L-terrestris/L-terrestris.github.io/README.md

# L-terrestris.github.io

Project website for Arizona State University EGR 557 FOldable Robotics Class
