L-terrestris/L-terrestris.github.io/index.md

---
title: EGR 557 Team 5
---

# Project Title : How can foldable techniques translate a small number of actuators into unique locomotion?

## Introduction
The team's semester project begun around the general topic of _Navigating Tight Spaces with Foldable Robotics_.\
The team was tasked with researching a more specific question through a semester-long course and following the preliminary research, we settled on modelling a robot with bio-inspiration from the _Lumbricus Terrestris_ commonly known as the _Common Earthworm_.\
However, After half the semester, we had a major project change. We have shifted from tight space navigation to locomotion, and seek to answer the following question:

“How can foldable techniques translate a small number of actuators into unique locomotion?”

Follow [this link](/OldStuff) for details on the previous work conducted on navigating tight spaces. 

## Team Members

| Jacob Sindorf | Javon Grimes | Jonathan Nguyen |Gilgal Ansah |
| <jsindorf@asu.edu> | <jdgrime1@asu.edu> | <jrnguyen@asu.edu> | <gjansah@asu.edu> |

## Assignments

1. [Develop a Research Question](Question/QuestionNew)
2. [Biomechanics Background and Initial Specifications](Biomechanics/BiomechanicsNew)
3. [System Kinematics](Kinematics/KinematicsNew)
4. [System Dynamics](Dynamics/DynamicsNew)
5. [Design Optimization](Optimization/Optimization)
6. [Design and Manufacturing Workflow](Manufacturing/Manufacturing)
7. [Data Collection and Experimental Validation](Validation/Validation)

## Project Presentations
1. [Presentation 1](Presentations/Presentation_1)
2. [Presentation 2](Presentations/Presentation_2)
3. [Presentation 3](Presentations/Presentation_3)

## [Bibliography](/bibliographyNew)
