L-terrestris/L-terrestris.github.io/Presentations/Presentation_3.md

---
title: Presentation 3
---

# Presentation 3

## Description
[Assignment Instructions](https://egr557.github.io/assignments/presentation-III.html)

## Team Response
### Videos
The video shows the final  team presentation.

<iframe width="974" height="548" src="https://www.youtube.com/embed/8ZwU1LzjtIA" title="YouTube video player" frameborder="0" allow="accelerometer; autoplay; clipboard-write; encrypted-media; gyroscope; picture-in-picture" allowfullscreen></iframe>

### [Presentation file](/PDF/Presentation3.pdf)
