L-terrestris/L-terrestris.github.io/Presentations/Presentation_2.md

---
title: Presentation 2
---

# Presentation 2

## Description
[Assignment Instructions](https://egr557.github.io/assignments/presentation-II.html)

## Team Response
### Videos
The video below discusses the team's project shift and covers the new system dynamics, kinematics as well as prototyping material identification.

<iframe width="974" height="548" src="https://www.youtube.com/embed/WqxZr-pha3U" title="YouTube video player" frameborder="0" allow="accelerometer; autoplay; clipboard-write; encrypted-media; gyroscope; picture-in-picture" allowfullscreen></iframe>

### [Presentation file](/PDF/Presentation2.pdf)
