L-terrestris/L-terrestris.github.io/Dynamics/ParameterID.md

---
title: Parameter Identification
---

### [Assignment Instructions](https://egr557.github.io/assignments/dynamics-ii-prep.html)

1. [Kinematics Via Prototyping and CAD](FEA.pdf)
2. [Cantilever Experiment](CantileverBeam)
3. [Prototype - Leg](SarrusLeg)
4. [Prototype - Flexible Spine](Spine)
5. [Motor Analysis](Motor)
