L-terrestris/L-terrestris.github.io/Presentations/Presentation_1.md

---
title: Presentation 1
---

# Presentation 1

## Description
[Assignment Instructions](https://egr557.github.io/assignments/presentation-I.html)

## Team Response
### Videos
The videos show the initial and final takes for the first team presentation.

<iframe width="400" height="315" src="https://www.youtube.com/embed/iwJ6JhAadY0" frameborder="0" allow="accelerometer; autoplay; clipboard-write; encrypted-media; gyroscope; picture-in-picture" allowfullscreen></iframe>

<iframe width="400" height="315" src="https://www.youtube.com/embed/TYOn1yv-m28" frameborder="0" allow="accelerometer; autoplay; clipboard-write; encrypted-media; gyroscope; picture-in-picture" allowfullscreen></iframe>

### [Presentation file](/PDF/Presentation1.pdf)
