L-terrestris/L-terrestris.github.io/PDF/Presentation3.pdf

# Team 5- Final Presentation

### Members:

### Gilgal Ansah Javon Grimes Jonathan Nguyen Jacob Sindorf

### Refined Research Question:

### “How can foldable techniques translate a small number of actuators into unique locomotion?”

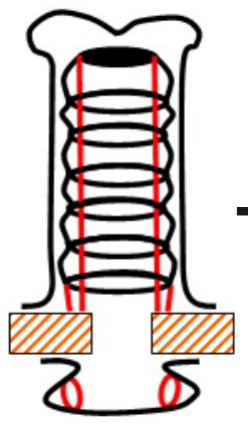
[picture p69: figure]

Figure 1: Tube foot
(podia) bioinspiration [1]

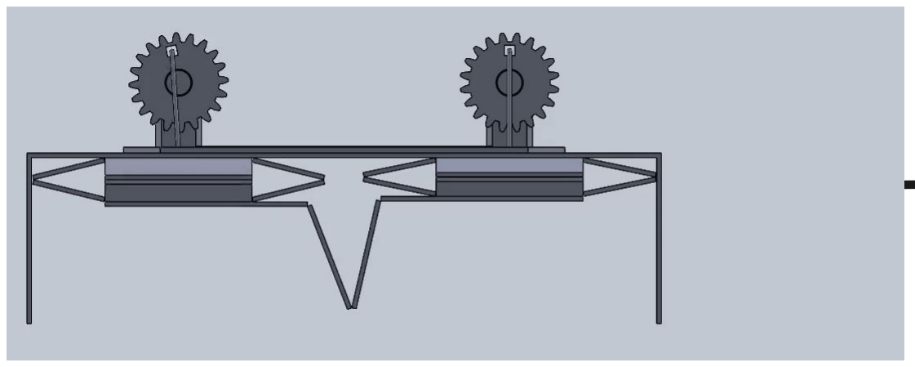
[picture p70: figure]

Figure 2: Conceptual device drawing

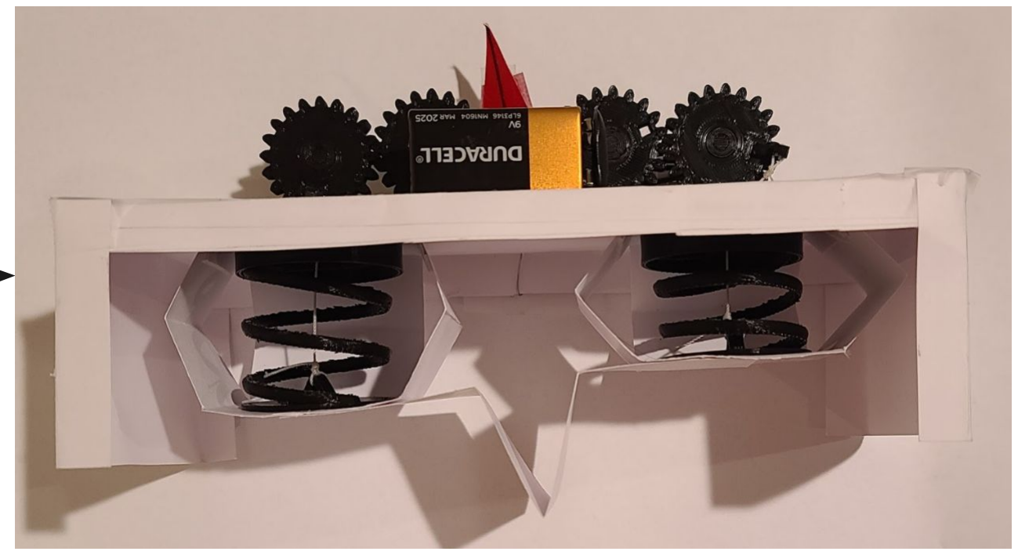
[picture p71: figure]

Figure 3: Final Device Design

# Manufacturing

1 Sheet VS 5 Sheet | Figure 4: 1 Layer Design | Figure 5: 5 Layer Design

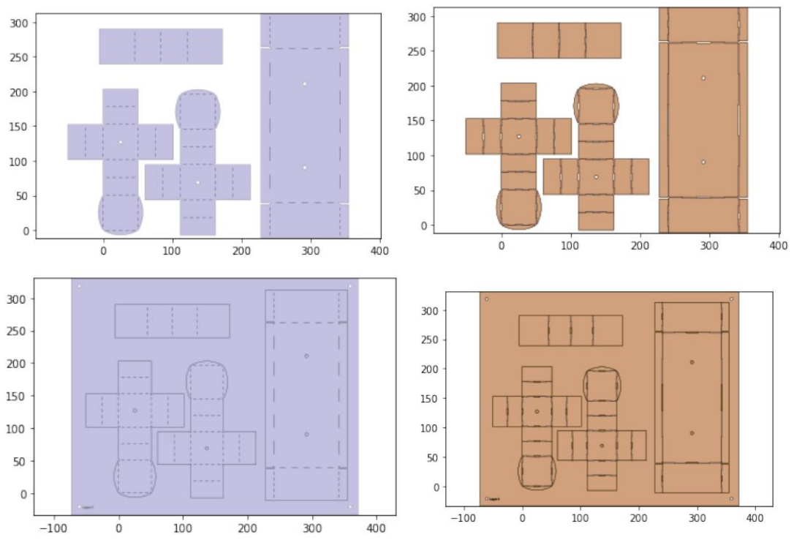
[picture p72: figure]

Pros
- More easily cut out of
single large sheet
- Simpler hinges
- Easier to create digitally

Cons
- Flimsier depending on
materials
- Requires added spring
- Perforated hinges more
subject to degradation
- Less versatility

# Manufacturing- Use in Design

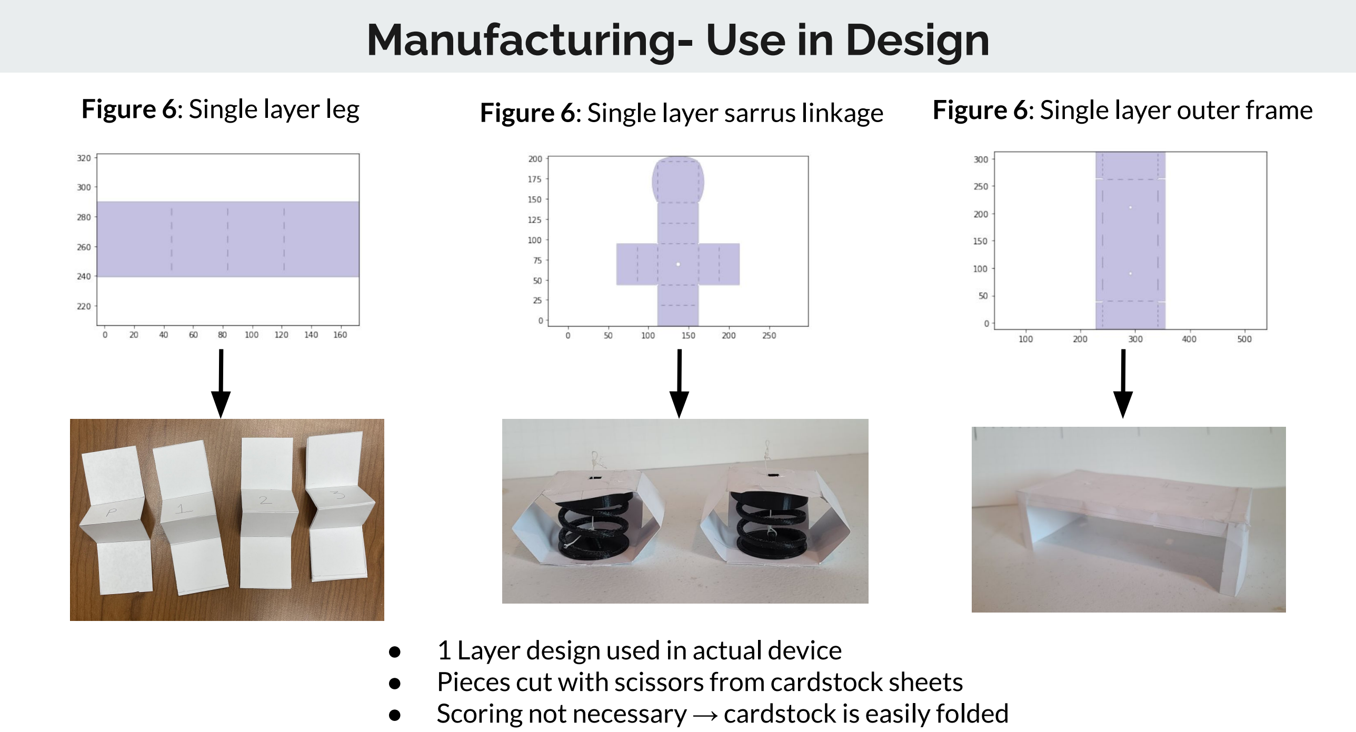
[picture p73: page 3]

- 1 Layer design used in actual device
- Pieces cut with scissors from cardstock sheets
- Scoring not necessary → cardstock is easily folded
Figure 6: Single layer leg | Figure 6: Single layer sarrus linkage | Figure 6: Single layer outer frame

# Optimization

Dynamic model
- Updated with position/time plots
- Measures effectiveness of movement
- Constraints
- Stability of movement
- Amount of movement
- .3 and .6 had best results with .9 dropping in distance
- Test values of .3 to .9 to find optimal value

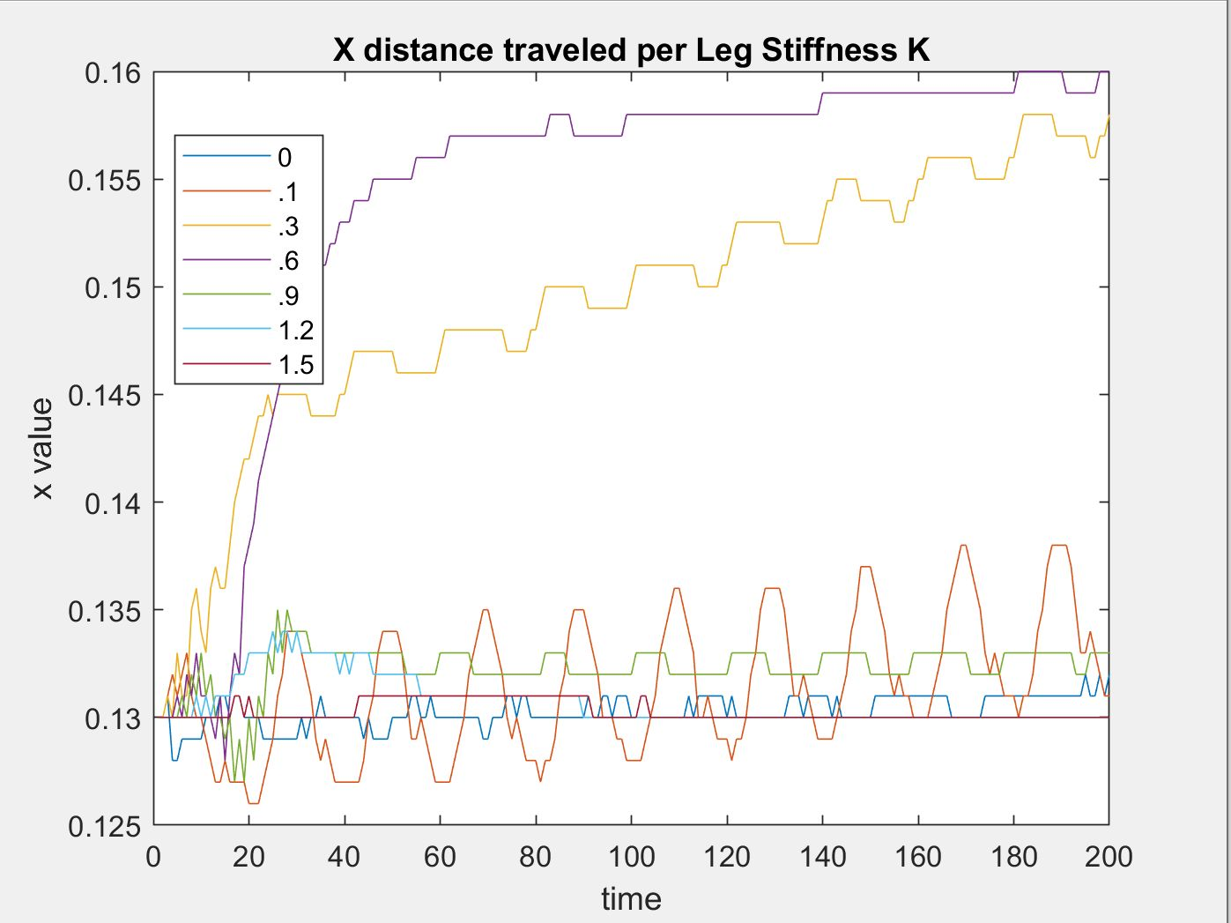
[picture p74: figure]

Figure 9: Varied stiffness values and their overall distance traveled

# Optimization

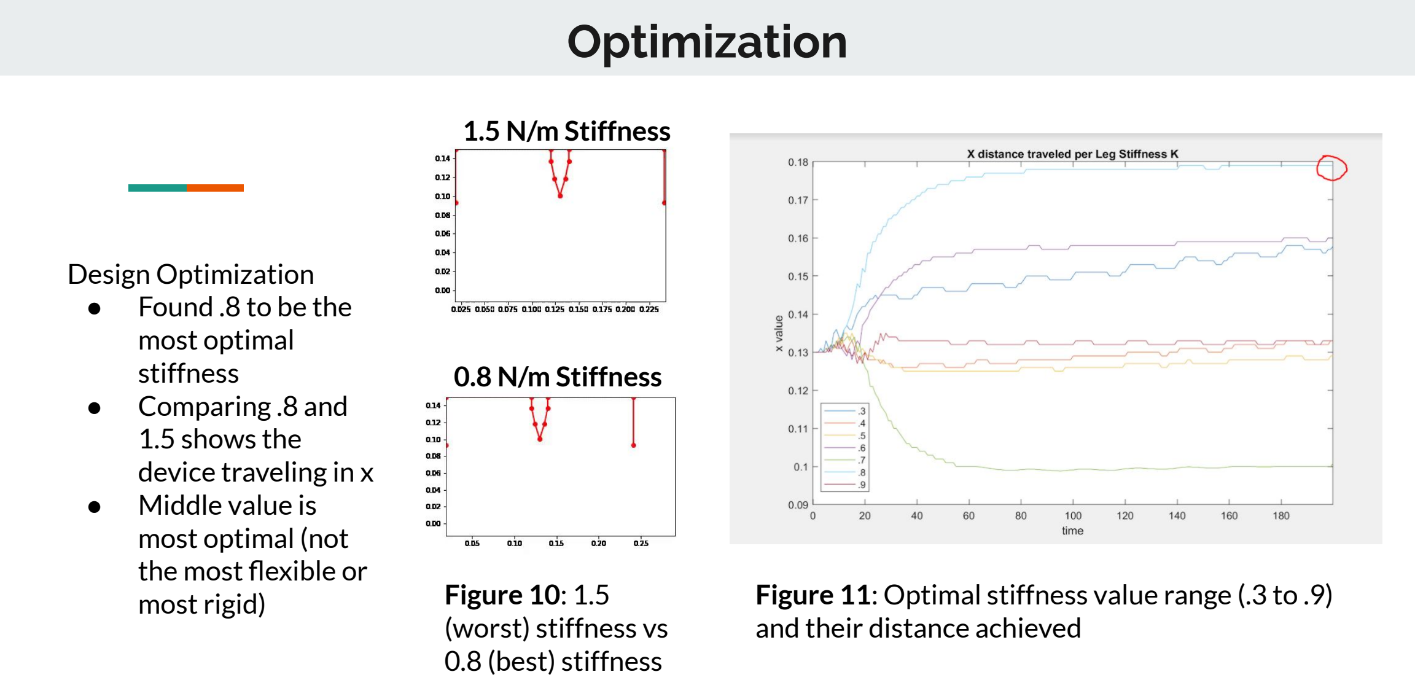
[picture p75: page 5]

Figure 10: 1.5
(worst) stiffness vs
0.8 (best) stiffness

### 1.5 N/m Stiffness

### 0.8 N/m Stiffness

Figure 11: Optimal stiffness value range (.3 to .9) and their distance achieved

Design Optimization
- Found .8 to be the
most optimal
stiffness
- Comparing .8 and
1.5 shows the
device traveling in x
- Middle value is
most optimal (not
the most flexible or
most rigid)

# Experimental Validation - System Assembly

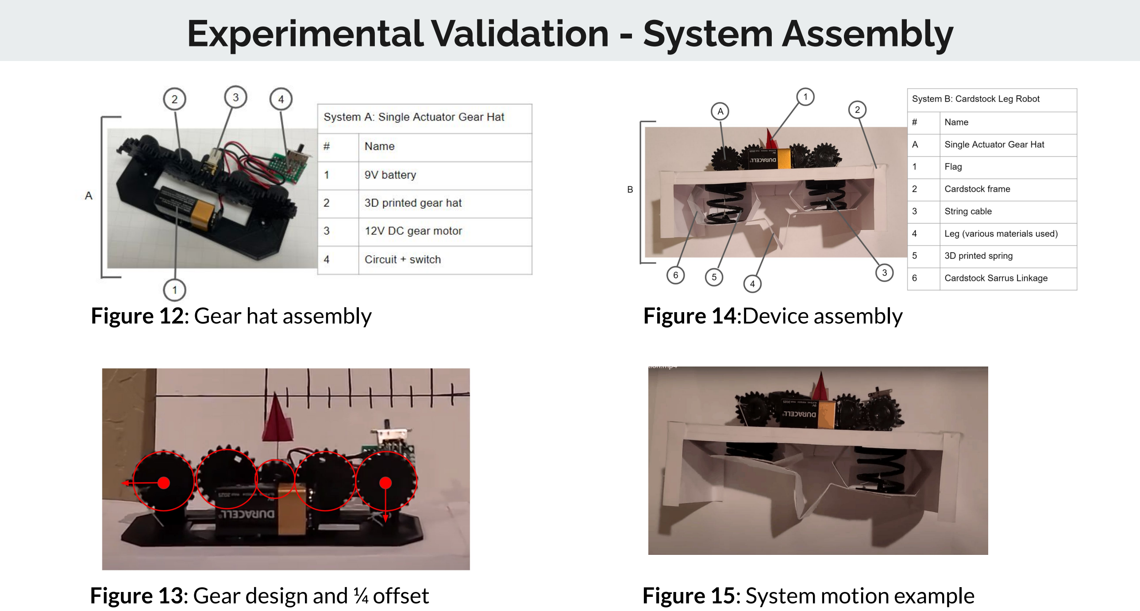
[picture p76: page 6]

Figure 12: Gear hat assembly | Figure 14:Device assembly
Figure 13: Gear design and ¼ offset | Figure 15: System motion example

# Experimental Validation - Experimental Setup

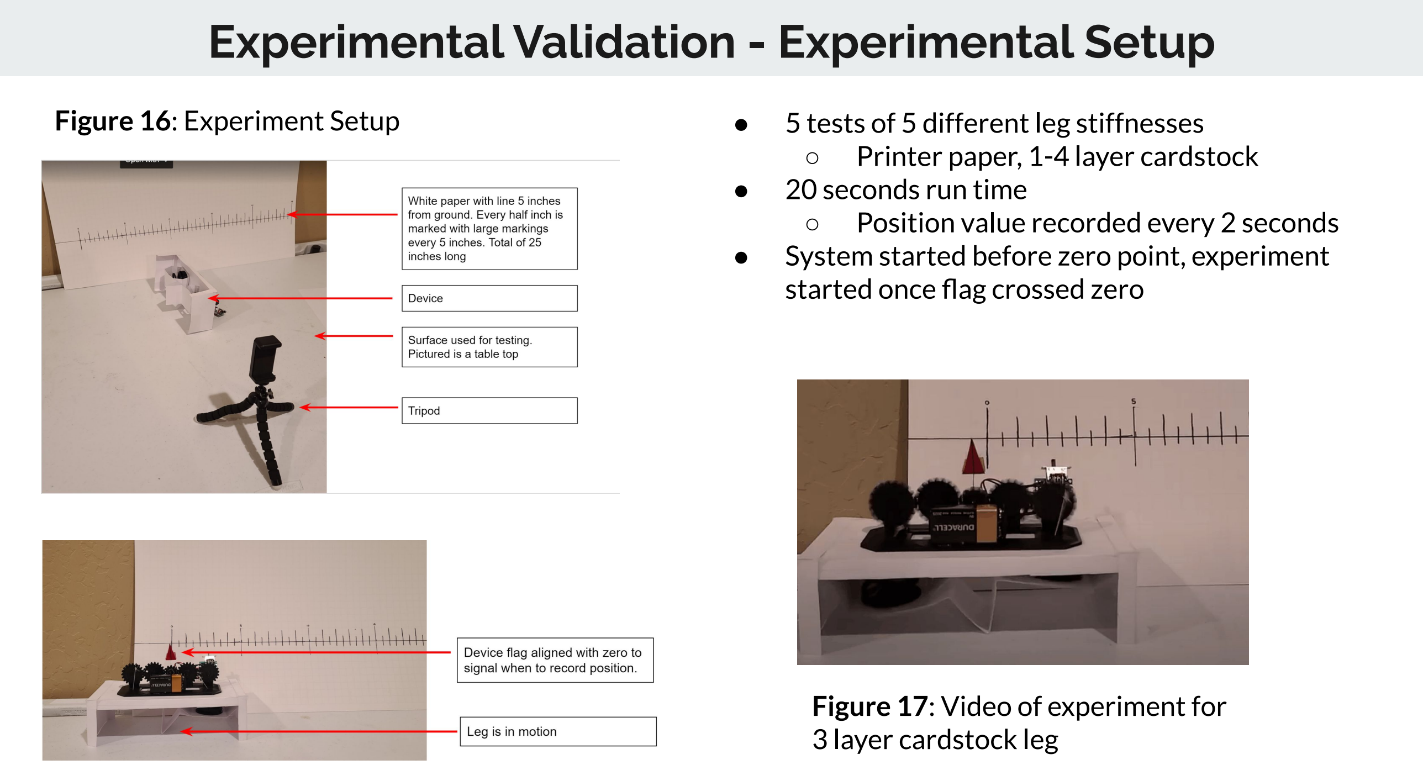
[picture p77: page 7]

Figure 16: Experiment Setup

Figure 17: Video of experiment for 3 layer cardstock leg

- 5 tests of 5 different leg stiffnesses
- Printer paper, 1-4 layer cardstock
- 20 seconds run time
- Position value recorded every 2 seconds
- System started before zero point, experiment started once flag crossed zero

# Experimental Validation - Results

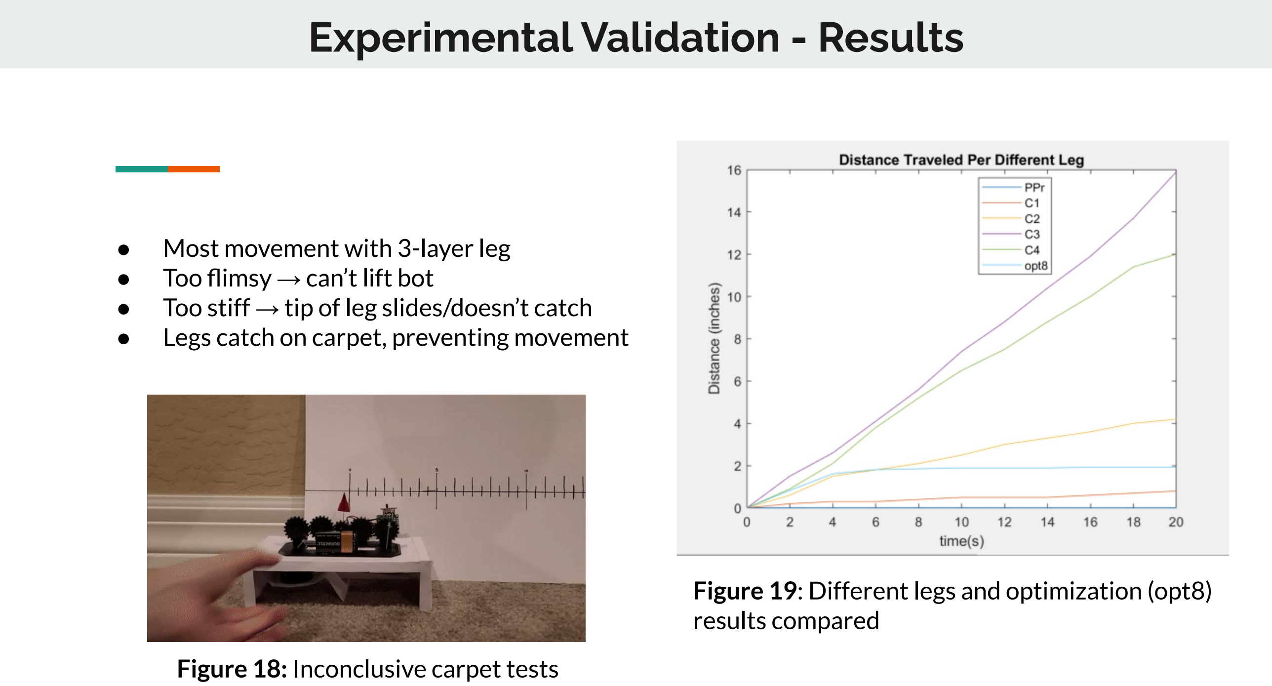
[picture p78: page 8]

- Most movement with 3-layer leg
- Too flimsy → can’t lift bot
- Too stiff → tip of leg slides/doesn’t catch
- Legs catch on carpet, preventing movement

Figure 19: Different legs and optimization (opt8) results compared

Figure 18: Inconclusive carpet tests

# Conclusions

Impact
- Roboticists
- Under-actuated + Low-cost materials + Foldable techniques = Easily manufacturable
- To public
- Foldable techniques provide easily accessible robots and can be used to introduce more people to robotics.
■ Similar to kamigami robots
- To broader research community
- Research of starfish podia is not as prevalent as research of sea urchin podia
- System could be put upside down to move a horizontal plate
■ A more common experiment with podia design

We achieve unique locomotion with a single actuator and a cardstock leg, thus answering our research question. Possible future expansion: multi-layered foldable techniques, alternate methods of under-actuation

# References

[1] Cronodon BioTech, Asteroid mechanics, “Asteroids 2- Hydraulic systems” https://cronodon.com/BioTech/Asteroids_hydraulics.html

# Design Iterations

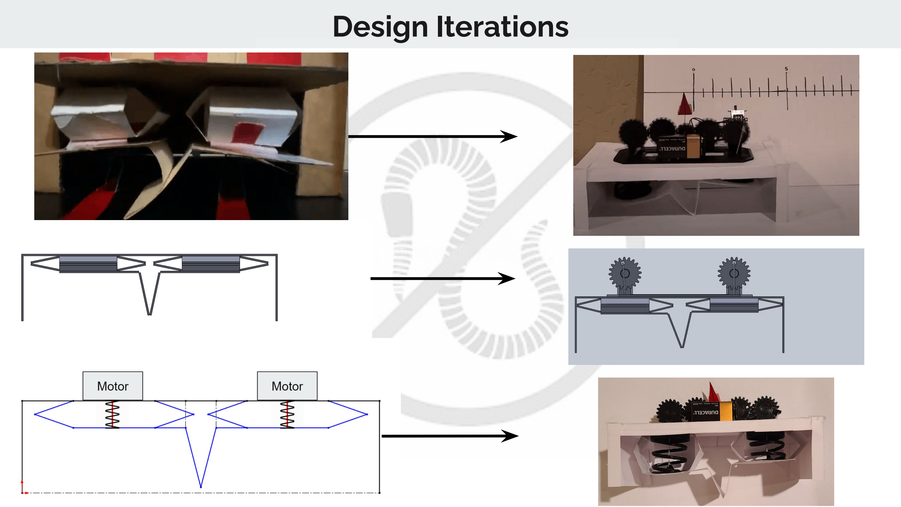
[picture p79: page 11]
