L-terrestris/L-terrestris.github.io/PDF/Presentation2.pdf

# Team 5- Project Update

### Members:

### Gilgal Ansah Javon Grimes Jonathan Nguyen Jacob Sindorf

### Refined Research Question:

### “How can foldable techniques translate a small number of actuators into unique locomotion?”

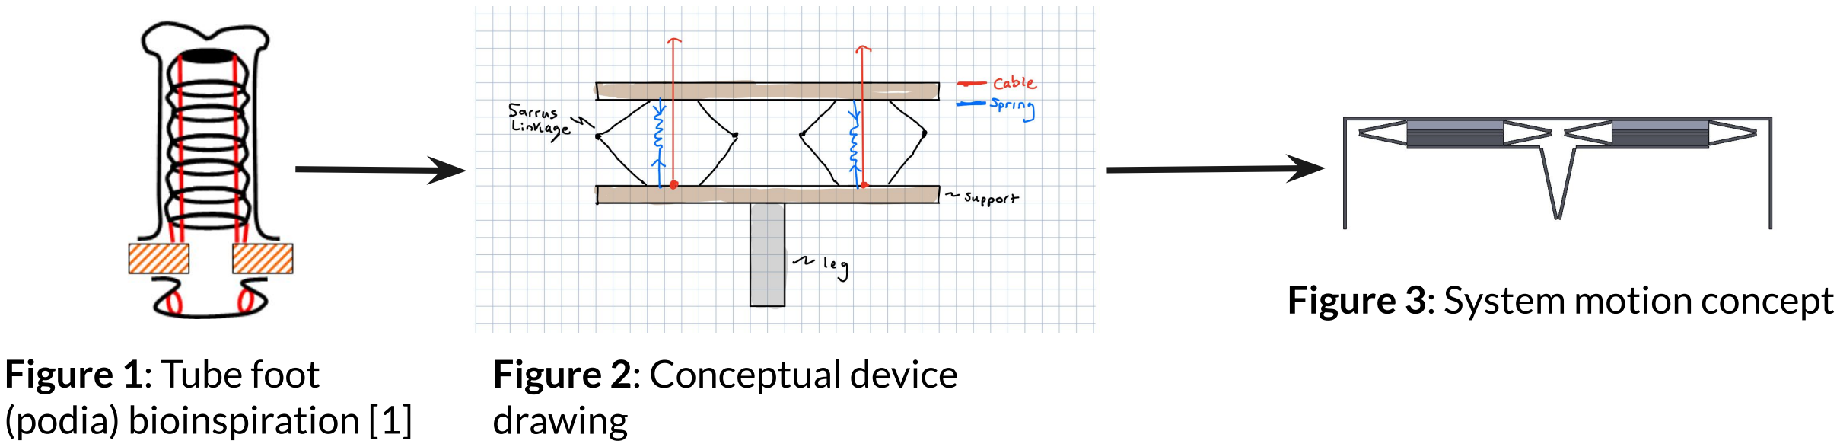
[picture p80: figure]
Figure 1: Tube foot (podia) bioinspiration [1]; Figure 2: Conceptual device drawing; Figure 3: System motion concept

- Bio-Inspiration change

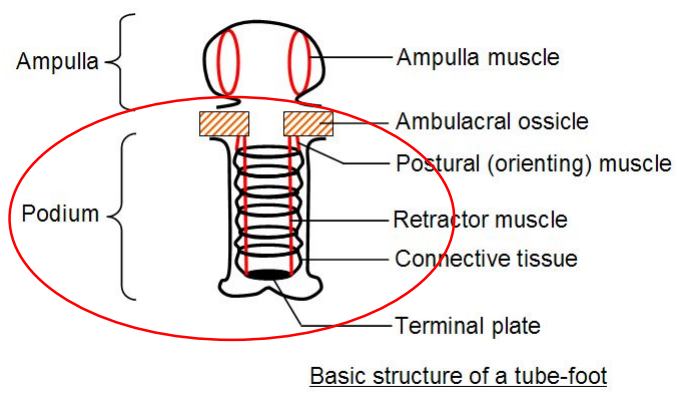
[picture p81: figure]

- Lumbricus Terrestris peristalsis → starfish tube foot (podia)
- More interesting motion through foldable techniques.
- Spec Changes?
- Cardstock still viable; can be layered for strength/stiffness.
- Only need to support weight of actuator/power source/controller → Number of actuators remains the same.
■ More actuators → more complex motion achievable
- Sarrus linkage properties able to be reused.

# Current Specifications

Figure 4: Basic structure
of a tube foot [1]

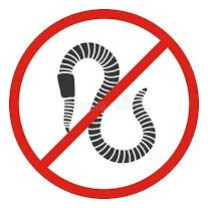
[picture p82: figure]

# Dynamics

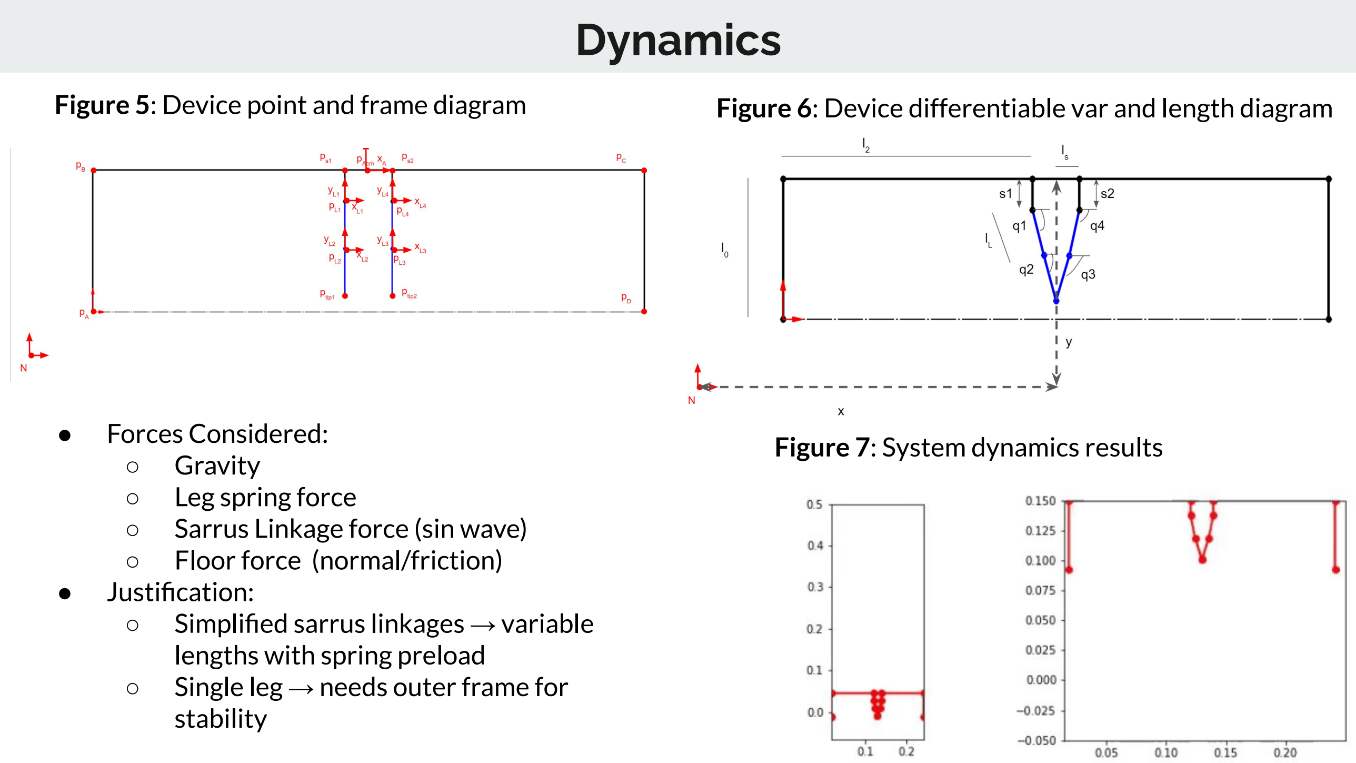
[picture p83: page 3]

Figure 5: Device point and frame diagram | Figure 6: Device differentiable var and length diagram
Figure 7: System dynamics results ● | Forces Considered:
- Gravity
- Leg spring force
- Sarrus Linkage force (sin wave)
- Floor force (normal/friction)
- Justification:
- Simplified sarrus linkages → variable lengths with spring preload
- Single leg → needs outer frame for stability

# Data Collection, Parameter Id, and Model Fitting

# Prototype and Motion

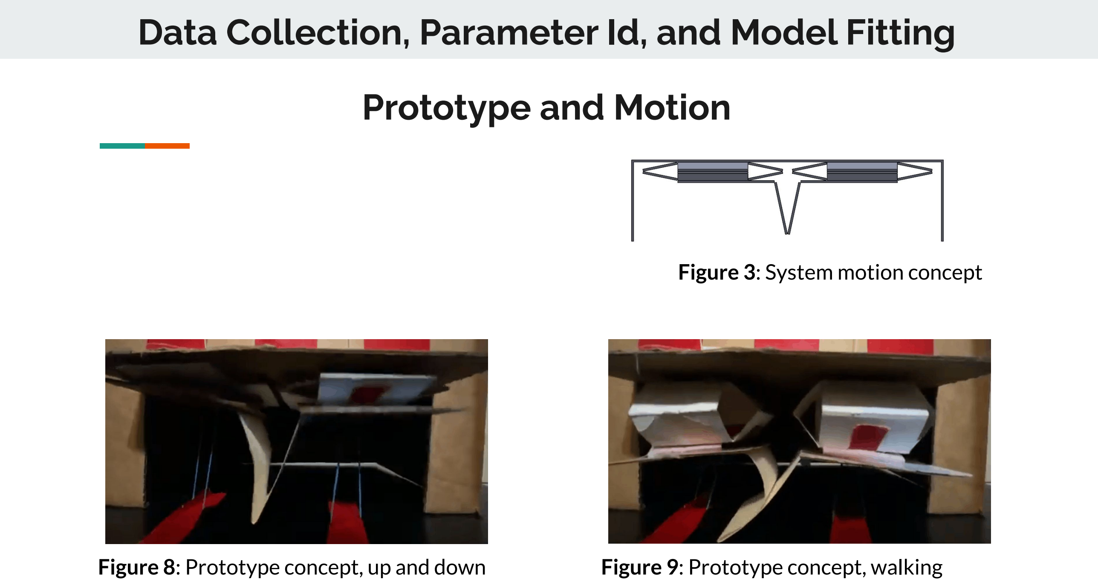
[picture p84: page 4]

Figure 3: System motion concept

Figure 8: Prototype concept, up and down | Figure 9: Prototype concept, walking

# Data Collection, Parameter Id, and Model Fitting

# Cantilever Beam and Stiffness

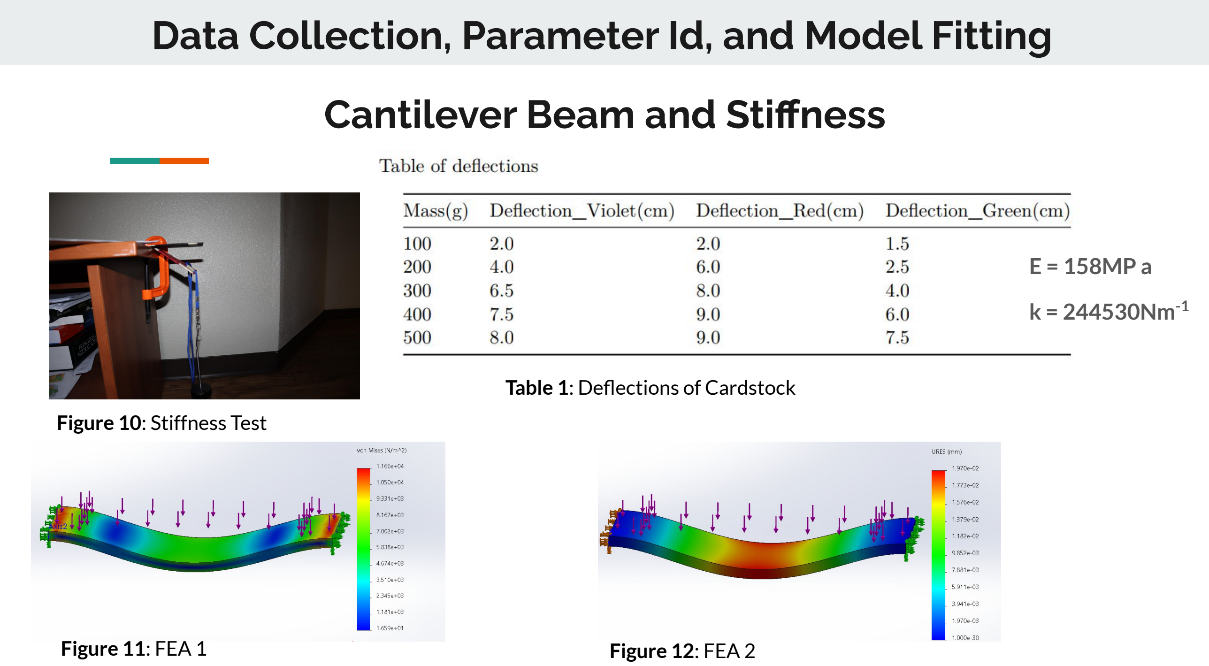
[picture p85: page 5]

E = 158MP a

k = 244530Nm⁻¹

Figure 10: Stiffness Test

Figure 11: FEA 1 | Figure 12: FEA 2

Table 1: Deflections of Cardstock

# Motor Analysis and System Weight

Metric | Value
Voltage Range (VDC) | 3-12
Max Current (A) | 0.17
Max Torque (N-m) | 0.002481
Pulley Radius (cm) | 2.54
Force(mN) | 97.68
Motor Weight (g) | 50
System Weight (g) | 57

# Data Collection, Parameter Id, and Model Fitting

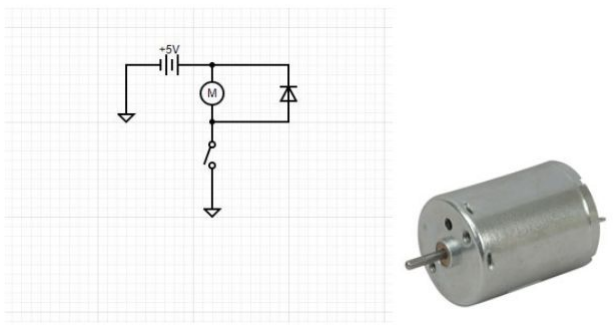
[picture p86: figure]

Figure 13: Motor circuit diagram and DC
Table 2 | motor : Motor Specifications

# Future Plans

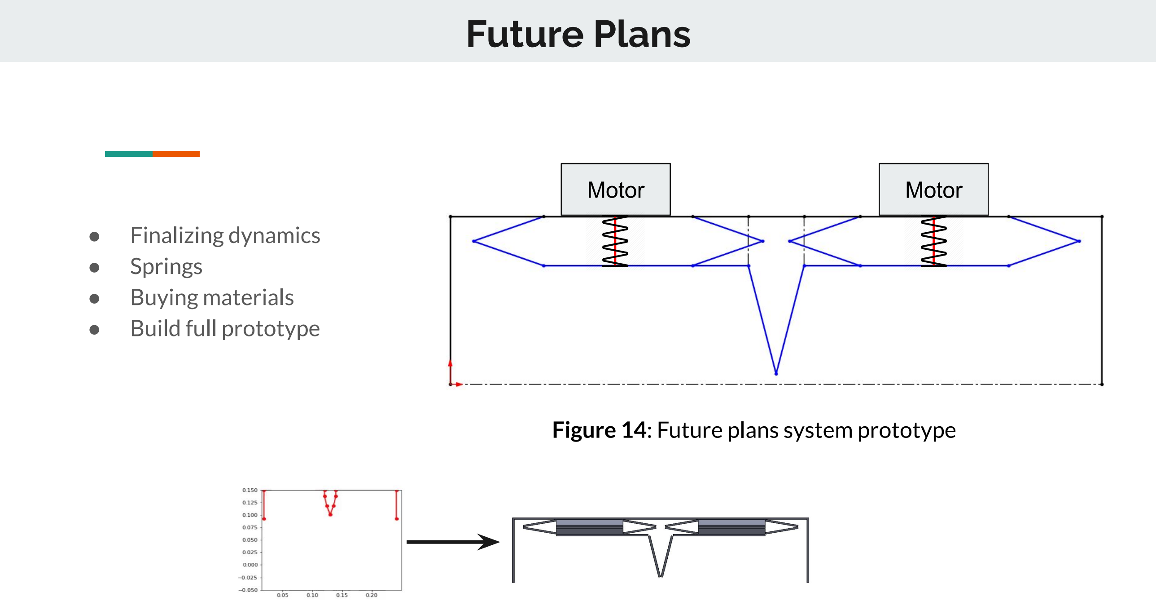
[picture p87: page 7]

| Motor | Motor
- Finalizing dynamics ● Springs ● Buying materials ● Build full prototype

Figure 14: Future plans system prototype

# References

[1] Cronodon BioTech, Asteroid mechanics, “Asteroids 2- Hydraulic systems” https://cronodon.com/BioTech/Asteroids_hydraulics.html
