L-terrestris/L-terrestris.github.io/Dynamics/V2Team5_SystemDynamics.md

```python
%matplotlib inline
```

```python
global_q = False
use_constraints = True
```

```python
!pip install pypoly2tri idealab_tools foldable_robotics pynamics
```

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

```python
# -*- coding: utf-8 -*-
"""
Written by Daniel M. Aukes
Email: danaukes<at>gmail.com
Please see LICENSE for full license.
"""

import pynamics
from pynamics.frame import Frame
from pynamics.variable_types import Differentiable,Constant
from pynamics.system import System
from pynamics.body import Body
from pynamics.dyadic import Dyadic
from pynamics.output import Output,PointsOutput
from pynamics.particle import Particle
import pynamics.integration
import sympy
import numpy
import scipy.optimize
import matplotlib.pyplot as plt
plt.ion()
from math import pi
```

```python
system = System()
pynamics.set_system(__name__,system)
```

```python

```

# Proposed System Kinematics v2



## Parameterization

### Constants

```python
h = Constant(0.0381, 'h',system) #height off the ground due to the front plate (can be set to 0 in the future)
l0 = Constant(0.0508,'l0',system)
la = Constant(0.0254,'la',system)
lb = Constant(0.0254,'lb',system)
lc = Constant(0.0254,'lc',system)
ld = Constant(0.0254,'ld',system)

#Changed to smaller weight to be more reasonable with the system
mA = Constant(.01,'mA',system)
mB = Constant(.01,'mB',system)
mC = Constant(.01,'mC',system)
mD = Constant(.01,'mC',system)

g = Constant(9.81,'g',system)
b = Constant(1e1,'b',system) #damping
k = Constant(1e1,'k',system) #spring force

#spring preloads to system
preload1 = Constant(20*pi/180,'preload1',system) # At-rest angle of NA (A w.r.t. N)
preload2 = Constant(-40*pi/180,'preload2',system) # At-rest angle of AB (B w.r.t. A)
preload3 = Constant(-40*pi/180,'preload3',system) # At-rest angle of DC (C w.r.t. D)
preload4 = Constant(20*pi/180,'preload4',system) # At-rest angle of ND (D w.r.t. N)

Ixx_A = Constant(1,'Ixx_A',system)
Iyy_A = Constant(1,'Iyy_A',system)
Izz_A = Constant(1,'Izz_A',system)
Ixx_B = Constant(1,'Ixx_B',system)
Iyy_B = Constant(1,'Iyy_B',system)
Izz_B = Constant(1,'Izz_B',system)
Ixx_C = Constant(1,'Ixx_C',system)
Iyy_C = Constant(1,'Iyy_C',system)
Izz_C = Constant(1,'Izz_C',system)
Ixx_D = Constant(1,'Ixx_D',system)
Iyy_D = Constant(1,'Iyy_D',system)
Izz_D = Constant(1,'Izz_D',system)

```

```python
tol = 1e-12
```

```python
#Animation stuff
tinitial = 0
tfinal = 10
fps = 30
tstep = 1/fps
t = numpy.r_[tinitial:tfinal:tstep]
```

```python
# Creating dynamic state variables. system argument denotes them as state variables for pynamics system from above
qA,qA_d,qA_dd = Differentiable('qA',system) #Angle between N and A
qB,qB_d,qB_dd = Differentiable('qB',system) #from AB
qC,qC_d,qC_dd = Differentiable('qC',system)
qD,qD_d,qD_dd = Differentiable('qD',system) #from DE

```

```python
#Initial condition based geometrically off of a solidworks model
#given 85 and 170 puts it into the 'compressed' state
#2bar
initialvalues = {}
# Setting initial angle values. See above for angle positions
#Listed are important angle configurations
#Smallest(Compressed) 85,170
#Middle ~45,90
#Largest(Extended) 0,0
initialvalues[qA]=85*pi/180  #45
initialvalues[qA_d]=0*pi/180 
initialvalues[qB]=-170*pi/180   #-90
initialvalues[qB_d]=0*pi/180

initialvalues[qC]=170*pi/180 #90
initialvalues[qC_d]=0*pi/180
initialvalues[qD]=-85*pi/180   #-45
initialvalues[qD_d]=0*pi/180
```

```python
statevariables = system.get_state_variables() # tried running this after vector calculation like i kinematics, but no apparent change...
ini0 = [initialvalues[item] for item in statevariables]
```

```python
N = Frame('N') # Initializing frames
A = Frame('A')
B = Frame('B')
C = Frame('C')
D = Frame('D')
```

```python
system.set_newtonian(N)
```

```python
#if not global_q:
#set rotation logic of frames. Kept all z at one and left the negative value in the initial condition calculation
#changing this caused errors in the system
A.rotate_fixed_axis_directed(N,[0,0,1],qA,system) # A reference frame rotates about N's ref frame in Z direction by qA amount
B.rotate_fixed_axis_directed(A,[0,0,1],qB,system)
C.rotate_fixed_axis_directed(D,[0,0,1],qC,system)
D.rotate_fixed_axis_directed(N,[0,0,1],qD,system)

#rotate each about the global reference frame. Add if else later to see which method is simpler
#else:
#  A.rotate_fixed_axis_directed(N,[0,0,1],qA,system) # A reference frame rotates about N's ref frame in Z direction by qA amount
#  B.rotate_fixed_axis_directed(N,[0,0,1],qB,system)
#  C.rotate_fixed_axis_directed(N,[0,0,1],qC,system)
#  D.rotate_fixed_axis_directed(N,[0,0,1],qD,system)
```

Vectors

claculated by using solving the two 2bar problem. Each vector containts the length constant and the previous point given the local reference frame. 

```python

pA = 0*N.x + (l0 + h)*N.y + 0*N.z

pB = pA + la*A.x
pBtip = pB + lb*B.x

pD = 0*N.x + h*N.y + 0*N.z
pC = pD + ld*D.x
pCtip = pC + lc*C.x

```

Center of mass

Considered the midpoint of each link as they will be uniform in size and material

```python
pAcm=pA+(la/2)*A.x
pBcm=pB+(lb/2)*B.x
pCcm=pC+(lc/2)*C.x
pDcm = pD + (ld/2)*D.x
pBCcm = pCtip + (l0/2)*N.y #get end effector 
```

Angular Velocity

```python
wNA = N.getw_(A) #Angular velocity of vector A w.r.t. N
wAB = A.getw_(B) #Angular velocity of vector B w.r.t. A
wDC = D.getw_(C) #Angular velocity of vector C w.r.t. D
wND = N.getw_(D) #Angular velocity of vector D w.r.t. N
```

```python
#vCtip = pCtip.time_derivative(N,system)
```

Define Inertias & Bodies

```python
IA = Dyadic.build(A,Ixx_A,Iyy_A,Izz_A)
IB = Dyadic.build(B,Ixx_B,Iyy_B,Izz_B)
IC = Dyadic.build(C,Ixx_C,Iyy_C,Izz_C)
ID = Dyadic.build(D,Ixx_D,Iyy_D,Izz_D)

BodyA = Body('BodyA',A,pAcm,mA,IA,system)
BodyB = Body('BodyB',B,pBcm,mB,IB,system)
BodyC = Body('BodyC',C,pCcm,mC,IC,system)
BodyD = Body('BodyD',D,pDcm,mD,ID,system)
BodyBCp = Particle(pBCcm,mB,'ParticleBC',system) #would we also need bodyE 
```

Forces & Torques

Defines the system forces, mainly relying on the spring force

```python
system.addforce(-b*wNA,wNA)
system.addforce(-b*wAB,wAB)
system.addforce(-b*wDC,wDC)
system.addforce(-b*wND,wND)

```

    <pynamics.force.Force at 0x7efdccdb2210>

```python
##########################################
#Shouldn't we only consider spring force on one point ? 
#########################################
#if not global_q:
system.add_spring_force1(k,(qA-preload1)*N.z,wNA)
system.add_spring_force1(k,(qB-preload2)*A.z,wAB)
system.add_spring_force1(k,(qC-preload3)*D.z,wDC)
system.add_spring_force1(k,(qD-preload4)*N.z,wND)
  
#else:
#    system.add_spring_force1(k,(qA-preload1)*N.z,wNA) 
#    system.add_spring_force1(k,(qB-qA-preload2)*N.z,wAB)
#    system.add_spring_force1(k,(qC-qD-preload3)*N.z,wDC)
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
