L-terrestris/L-terrestris.github.io/OldStuff.md

---
title: Navigating Tight Spaces
---

## Navigating Tight Spaces

The following describe the work done by our team in the space of designing a robot to navigate tight spaces using a small number of actuators. 

1. [Develop a Research Question](Question/Question)
2. [Biomechanics Background and Initial Specifications](Biomechanics/Biomechanics)
3. [System Kinematics](Kinematics/Kinematics)
4. [System Dynamics](Dynamics/Dynamics)

## [Bibliography](/bibliography)
