L-terrestris/L-terrestris.github.io/Manufacturing/Single_Layer_Cut.dxf

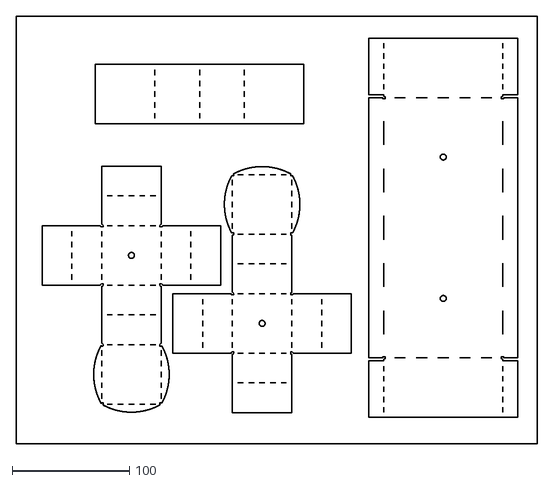
[picture p100: CAD file, 2021-04-16]
Manufacturing/Single_Layer_Cut.dxf
444.6 x 364.6
