L-terrestris/L-terrestris.github.io/Manufacturing/final_cut.dxf

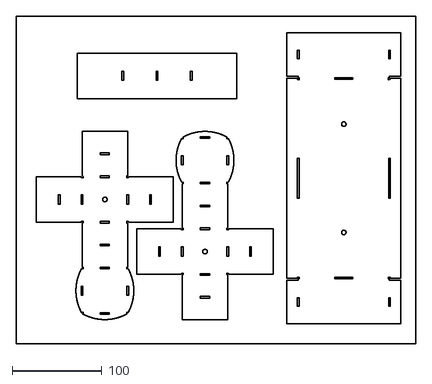
[picture p101: CAD file, 2021-04-16]
Manufacturing/final_cut.dxf
444.6 x 364.6
