L-terrestris/L-terrestris.github.io/Manufacturing/designJoints.dxf

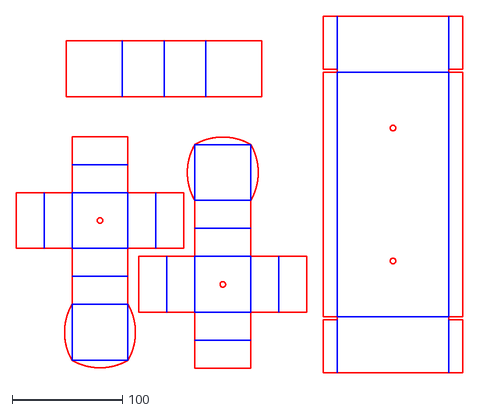
[picture p102: CAD file, 2021-04-16]
Manufacturing/designJoints.dxf
405.8 x 323.9
