L-terrestris/L-terrestris.github.io/Manufacturing/design.dxf

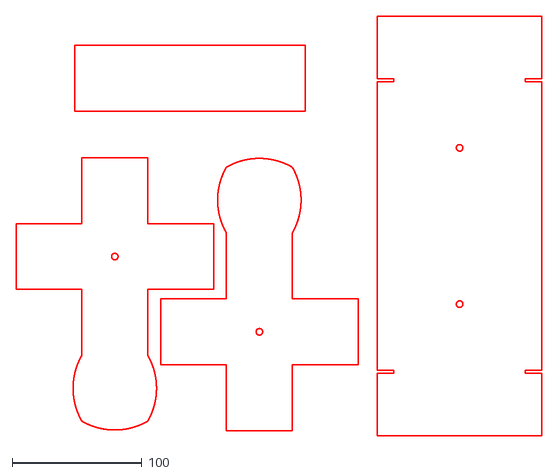
[picture p103: CAD file, 2021-04-16]
Manufacturing/design.dxf
405.8 x 323.9
