L-terrestris/L-terrestris.github.io/Manufacturing/rigid_layer.dxf

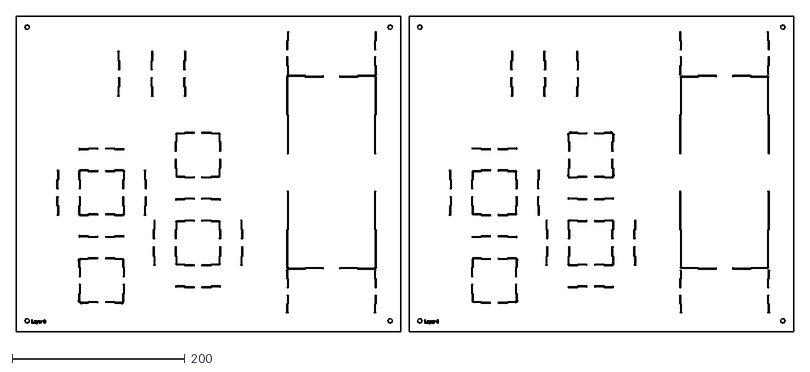
[picture p104: CAD file, 2021-04-16]
Manufacturing/rigid_layer.dxf
899.2 x 364.6
