L-terrestris/L-terrestris.github.io/Manufacturing/adhesive_layer.dxf

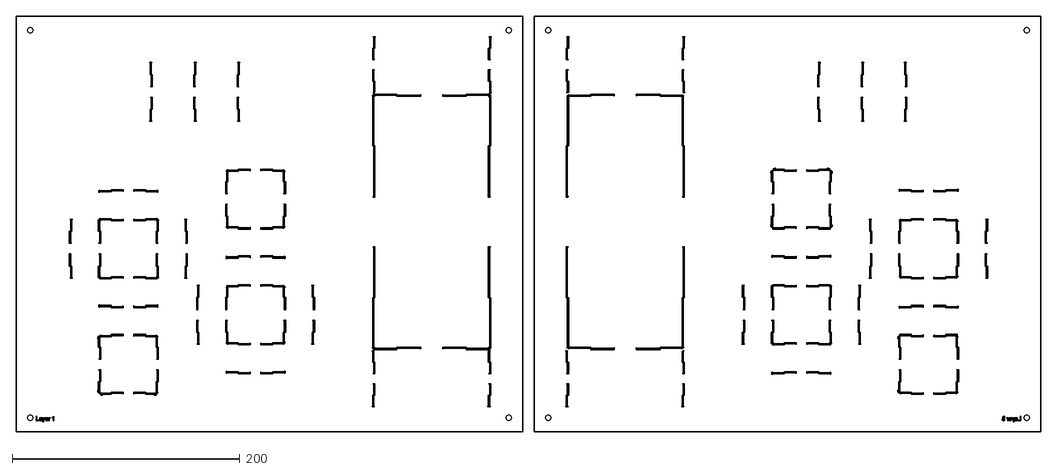
[picture p105: CAD file, 2021-04-16]
Manufacturing/adhesive_layer.dxf
899.2 x 364.6
