L-terrestris/L-terrestris.github.io/(list of files, cad)

Other CAD files:
Manufacturing/designJoints.dwg
