L-terrestris/L-terrestris.github.io/Manufacturing/Manufacturing.md

---
title: Design and Manufacturing Workflow
---

# 1 Paper Mockup

The paper mock up is identical to the solidworks design seen after. It uses the same measurements as the dynamics II assignments, and is made of cardboard (frame) and cardstock (leg and links). To hold everything together, tape can be used, but the final device would use glue as it would provide a cleaner connection. 

Folded:\
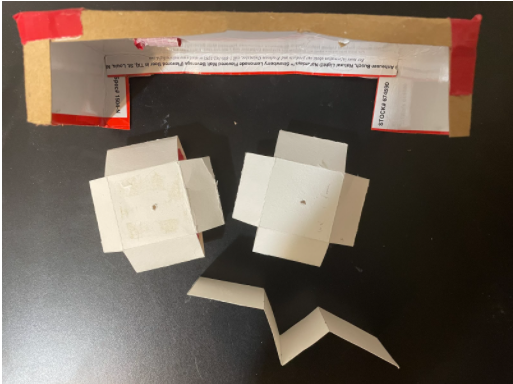
[picture p106: Manufacturing/PaperModelApart.PNG]

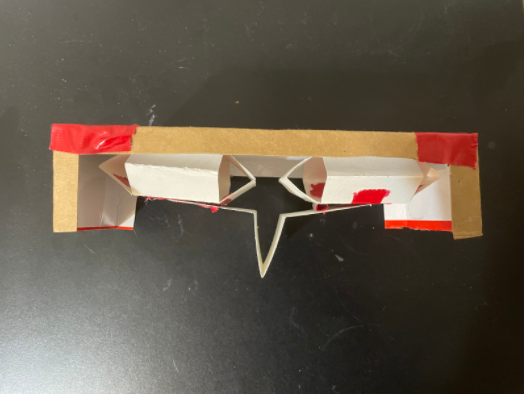
[picture p107: Manufacturing/PaperModelAssembled.PNG]


Flattened:\
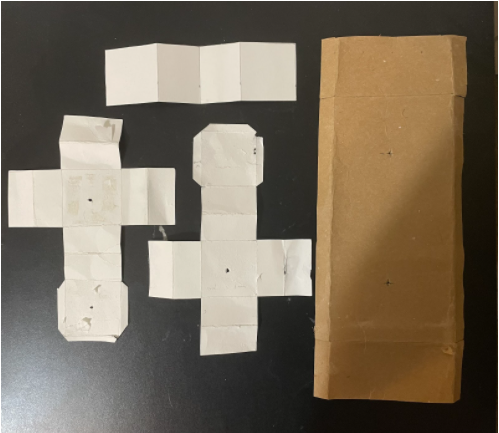
[picture p108: Manufacturing/PaperModelFlat.PNG]


# 2 Solidworks Model

The solidworks model seen here is a 3D version of our design. The folded states depicts both the assembled and exploded view for clarity. The flattened state represents the unfolded assembly in a way that can be used for manufacturing later. The system itself consists of 3 main parts, the sarrus linkages (x2), the frame, and the leg. Holes in the device are for the motor cable to move through, and flaps are used to adhere joints to one another. 

Folded:
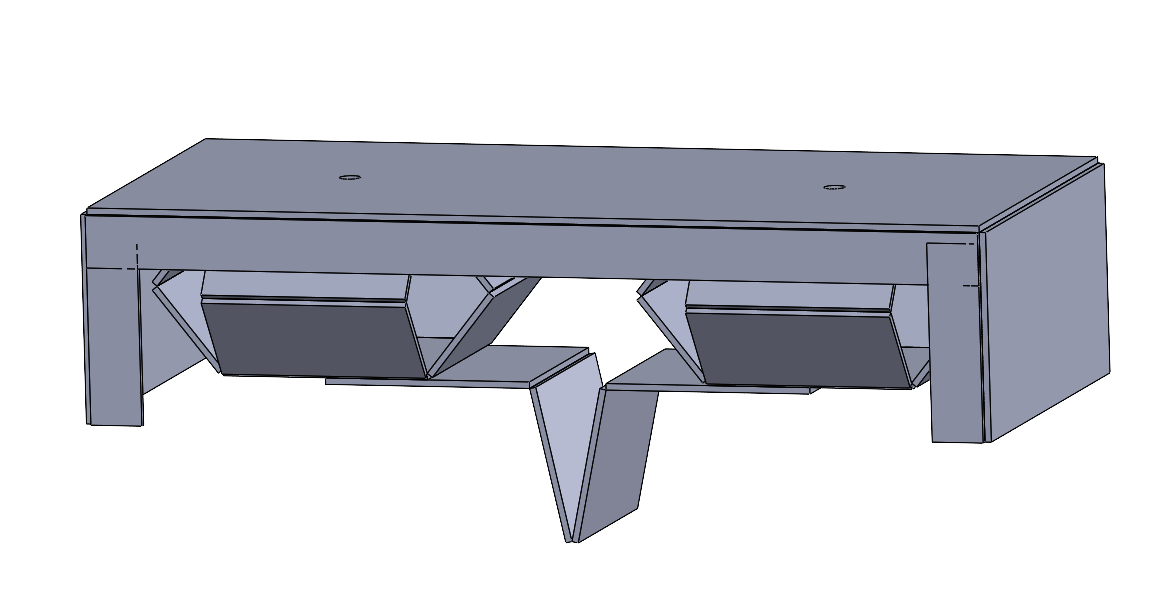
[picture p109: Manufacturing/SystemFolded.PNG]

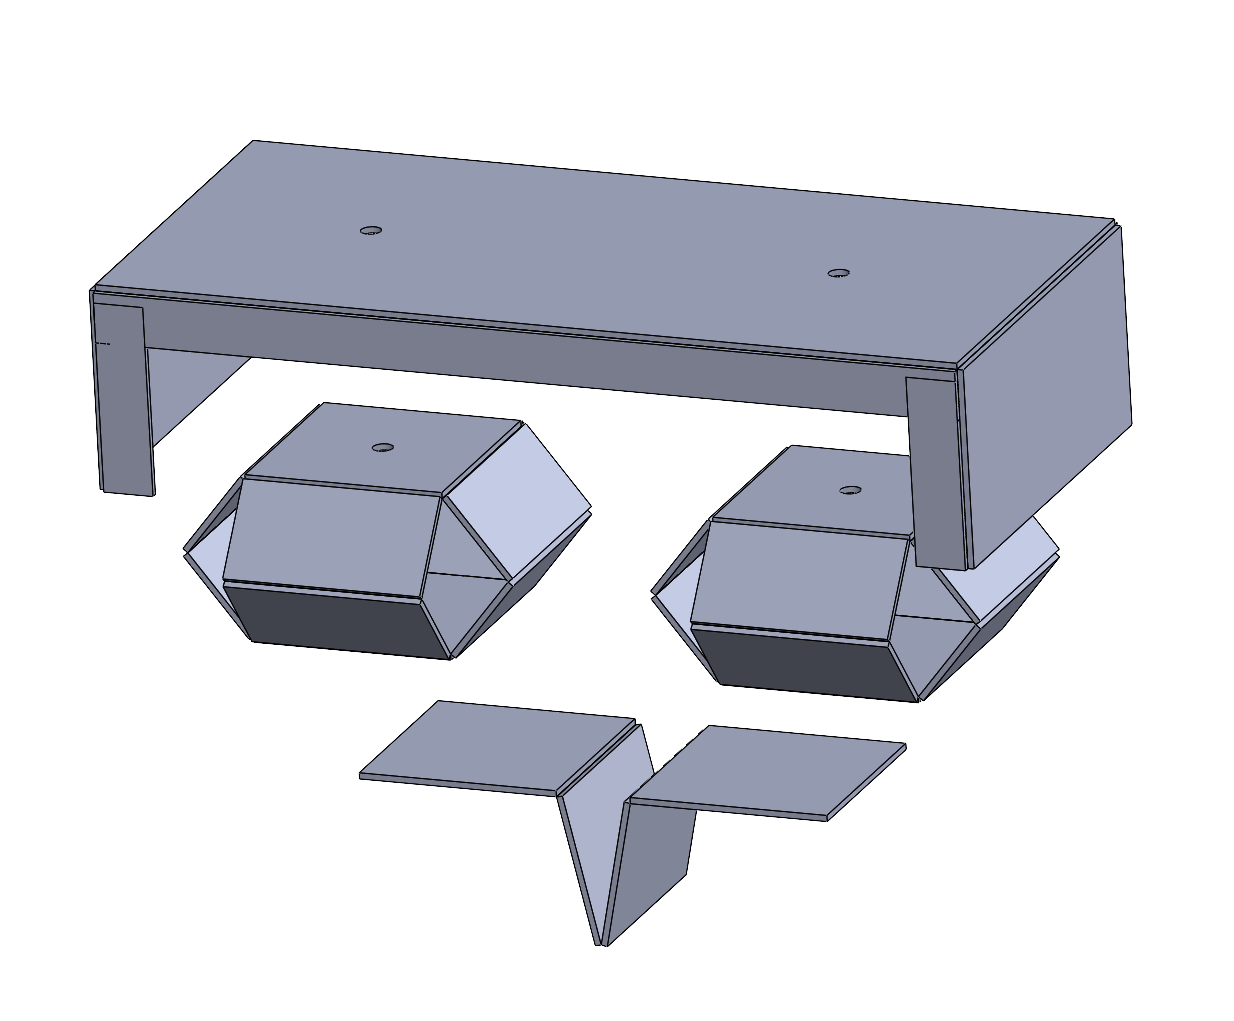
[picture p110: Manufacturing/SystemFoldedEXPL.PNG]


Flattened:
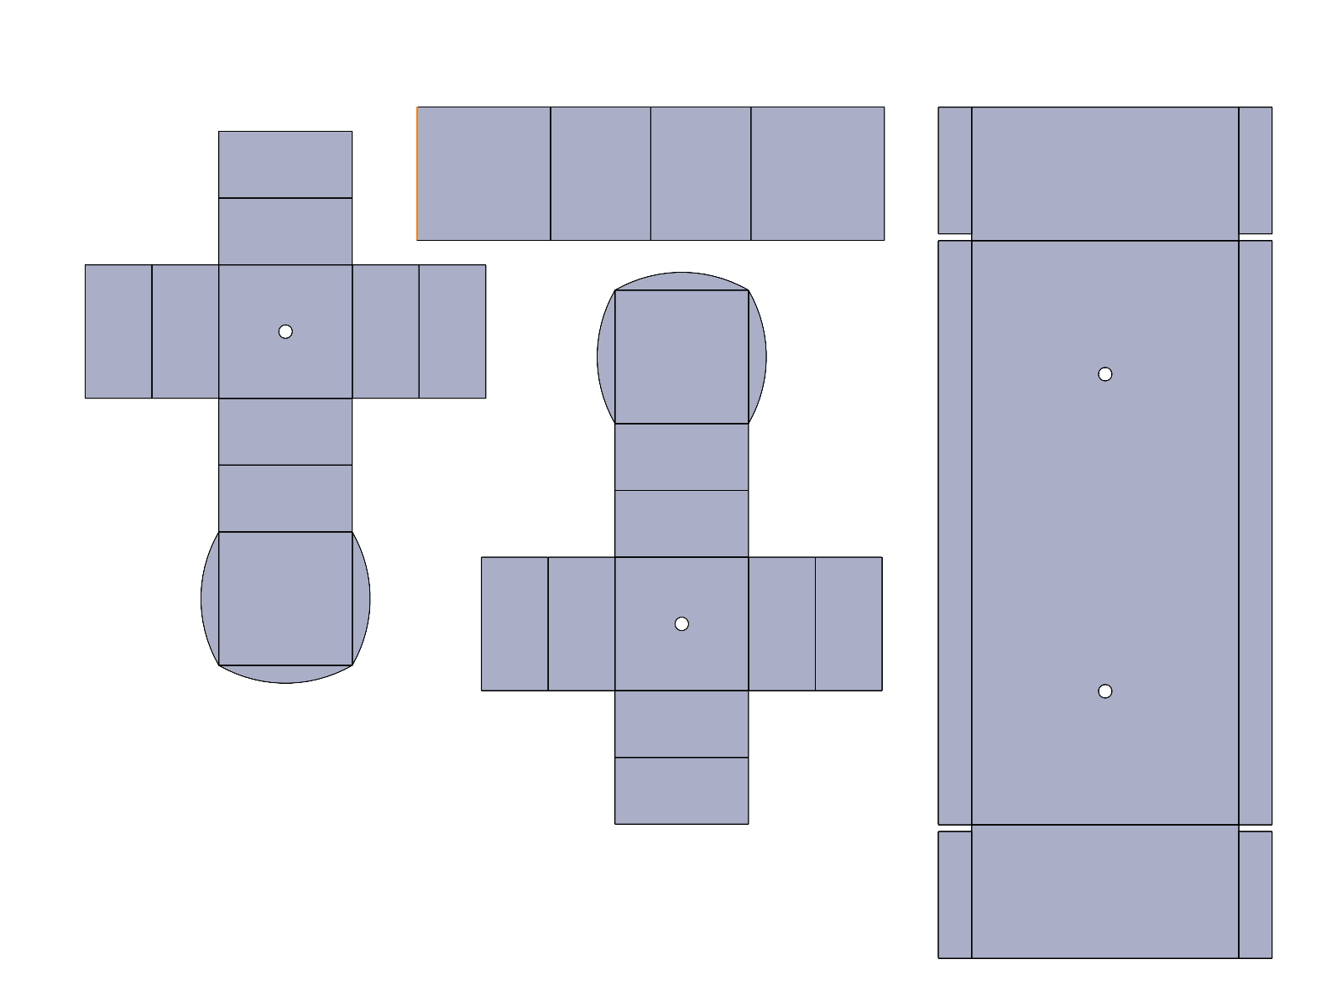
[picture p111: Manufacturing/SystemFlattened.PNG]


# 3 DXF file 

The dxf file directly from solidworks (the method of retrieving the yaml file, then getting the dxf) had issues that left every joint. To troubleshoot, we attempted to add more verticies, and even manually adding them in the program draft sight, both to no avail. Eventually, we found a different program called libreCAD that functions similarly to draft sight. This allowed us to finally obtain the proper dxf file needed, with both body (red) and joint (blue) layers. 

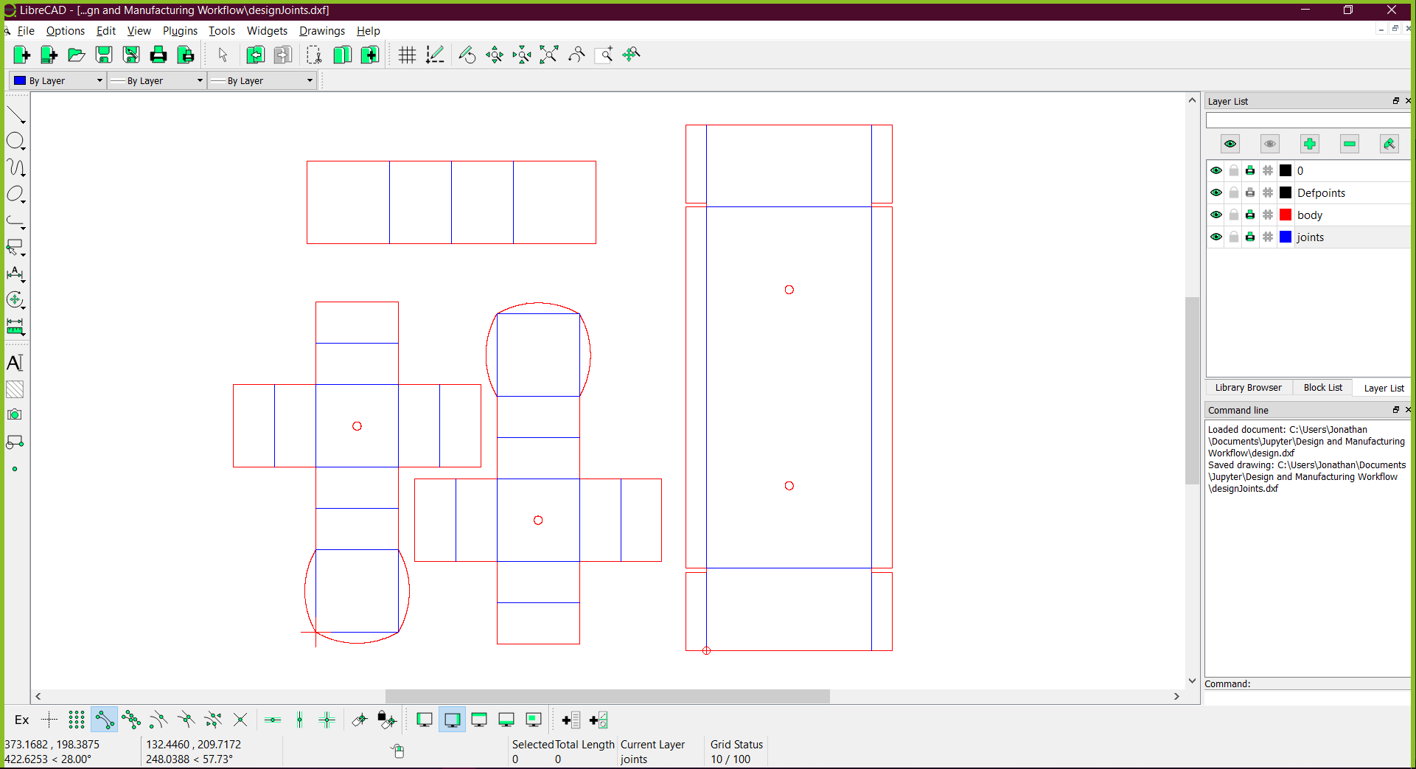
[picture p112: Manufacturing/LibreCADPic.PNG]


# 4 Jupyter Notebook

```python
import foldable_robotics
from foldable_robotics.layer import Layer
from foldable_robotics.laminate import Laminate
import shapely.geometry as sg
foldable_robotics.resolution=4
```

```python
import foldable_robotics
import foldable_robotics.dxf 
import numpy
import shapely.geometry as sg
from foldable_robotics.layer import Layer
from foldable_robotics.laminate import Laminate
import foldable_robotics.manufacturing
import foldable_robotics.parts.castellated_hinge1
import idealab_tools.plot_tris
from math import pi, sin,cos,tan
import idealab_tools.text_to_polygons
foldable_robotics.display_height=200
foldable_robotics.line_width=.5

from foldable_robotics.layer import Layer
from foldable_robotics.laminate import Laminate
import foldable_robotics
import foldable_robotics.dxf 
import foldable_robotics.manufacturing
import foldable_robotics.parts.castellated_hinge1
foldable_robotics.display_height=200
foldable_robotics.line_width=.5
#import workflow_support as ws

import os
import foldable_robotics.solidworks_support
```

```python
def get_bodies(filename, layername, num_layers):
    body = foldable_robotics.dxf.read_lwpolylines(filename,layer=layername, arc_approx = 10)

    bodies = [Layer(sg.Polygon(item)) for item in body]
    body = bodies.pop(0)
    for item in bodies:
        body ^= item
    body = body.to_laminate(num_layers)
    return body
```

```python
def get_hinge_lines(filename,layername):
    hinge_lines1 = foldable_robotics.dxf.read_lines(filename,layer=layername)
    hinge_lines2 = foldable_robotics.dxf.read_lwpolylines(filename,layer=layername)
    hinge_lines3 = []
    for points in hinge_lines2:
        hinge_lines3.append(points[:2])
    hinge_lines = hinge_lines1 +hinge_lines3
    return hinge_lines
```

```python
def hinge_lines_to_hinges(hinge_lines,hinge):
    lam = Layer().to_laminate(len(hinge))
    all_hinges = []    
    for p3,p4 in hinge_lines:
        all_hinges.append(hinge.map_line_stretch((0,0),(1,0),p3,p4))
    all_hinges = lam.unary_union(*all_hinges)
    return all_hinges
```

```python
def get_cuts(filename,layername,thickness,num_layers):
    cut_lines = foldable_robotics.dxf.read_lines(filename,layer=layername)
    cut_lines += foldable_robotics.dxf.read_lwpolylines(filename,layer=layername, arc_approx = 10)
    
    cuts = []
    for item in cut_lines:
        cuts.append(Layer(sg.LineString(item)))
    cuts = Layer().unary_union(*cuts)
    cuts<<=thickness/2
    cuts = cuts.to_laminate(num_layers)
    return cuts   
```

```python
def get_holes(filename, layername,num_layers):
    holes = foldable_robotics.dxf.read_circles(filename,layer='holes')
    
    holes2 = []
    for center, radius in holes:
        holes2.append(sg.Point(*center).buffer(radius))
    holes_layer = Layer(*holes2)
    holes_lam = holes_layer.to_laminate(num_layers)  
    return holes_lam
```

```python
def hinge_width_calculator(desired_degrees,thickness):
    theta = (180-desired_degrees)*pi/180
    w=thickness/tan(theta)
    return w
```

```python
def polys_to_layer(l1):
    l1 = [sg.Polygon(item) for item in l1]
    l11 = Layer(l1.pop(0))
    for item in l1:
        l11 ^= Layer(item)
    return l11
```

```python
def output_pdf(filename,design2,x,y,layers_separate = True):
    design2 = design2.translate(x,y)
    design2=design2.scale(1/25.4,1/25.4)
    design2=design2.scale(foldable_robotics.pdf.ppi,foldable_robotics.pdf.ppi)
    if isinstance(design2,Laminate):
        if not layers_separate:
            p=foldable_robotics.pdf.Page(filename+'.pdf')
            for d in design2:
    #        d = design2[0]
                for item in d.exteriors()+d.interiors():
                    p.draw_poly(item)
            p.close()
        else:
            for ii,d in enumerate(design2):
                p=foldable_robotics.pdf.Page(filename+'{0:03f}.pdf'.format(ii))
                for item in d.exteriors()+d.interiors():
                    p.draw_poly(item)
                p.close()

    elif isinstance(design2,Layer):
        p=foldable_robotics.pdf.Page(filename+'.pdf')
        for item in design2.exteriors()+design2.interiors():
            p.draw_poly(item)
        p.close()
```

```python
def build_layer_numbers(num_layers, text_size = None, prop=None):
    text_size = text_size or 1
    prop = prop or {'family':'Arial','size':text_size}
    layer_ids = []
    for ii in range(num_layers): 
    
        l = idealab_tools.text_to_polygons.text_to_polygons('Layer '+str(ii),prop=prop)
        layer_ids.append(l)
    
    layer_ids = [polys_to_layer(item) for item in layer_ids]
    layer_id = Laminate(*layer_ids)
    return layer_id
```

```python
def build_web(design2,keepout,support_width,jig_diameter,jig_hole_spacing,is_adhesive):
    num_layers = len(design2)

    layer_id = build_layer_numbers(num_layers,text_size=jig_diameter)

    design_outer = foldable_robotics.manufacturing.unary_union(design2)
    bb1= (design_outer<<jig_hole_spacing/2).bounding_box()
    (x1,y1),p2 = bb1.bounding_box_coords()
    w,h = bb1.get_dimensions()
    w2 = round(w/jig_hole_spacing)*jig_hole_spacing
    h2 = round(h/jig_hole_spacing)*jig_hole_spacing
    
    points = []
    points.append(sg.Point(x1,y1))
    points.append(sg.Point(x1+w2,y1))
    points.append(sg.Point(x1,y1+h2))
    points.append(sg.Point(x1+w2,y1+h2))
    
    layer_id = layer_id.translate(x1+jig_diameter,y1-jig_diameter/2)
    placement_holes2 = Layer(*points)
    placement_holes2<<=(jig_diameter/2)
    sheet = (placement_holes2<<10).bounding_box()
    placement_holes2=placement_holes2.to_laminate(num_layers)
    sheet=sheet.to_laminate(num_layers)
    
    removable_scrap = calculate_removable_scrap(design2,sheet,support_width,is_adhesive)
    
    web = (removable_scrap-placement_holes2)-layer_id
    return web,sheet
```

```python
def calculate_removable_scrap(design,sheet,width,is_adhesive):
    '''this computes all removable scrap given a sheet, a design, and a clearance width'''
    all_scrap = sheet-design

    ru = foldable_robotics.manufacturing.not_removable_up(design,is_adhesive)
    rd = foldable_robotics.manufacturing.not_removable_down(design,is_adhesive)
    
    removable_scrap_up = all_scrap-(ru<<width)
    removable_scrap_down = all_scrap-(rd<<width)

    removable_scrap = removable_scrap_up|removable_scrap_down
    return removable_scrap
```

```python
#user_path = os.path.abspath(os.path.expanduser(‘~’)) user_path
```

```python
folder='F:/EGR 557/Team5_Design and Manufacturing Workflow/Design and Manufacturing Workflow/'
# folder = 'C:/Users/Jonathan/Documents/Jupyter/Design and Manufacturing Workflow/'                       #folder with yaml file
input_filename = folder+'TESTFlatSystemPart - Sheet1_Drawing View1.yaml'                      #All flattened assemblies
#input_filename = folder+'SarrusLinkage - Sheet1_Drawing View1.yaml'                        #Only sarrus linkage
output_file_name = 'design.dxf'
New_output_file_name = 'designJoints.dxf'
```

```python
round_digits = 2
prescale=1000
jig_diameter = 5
support_width = 1
kerf = .05
jig_hole_spacing=20
is_adhesive1 = [False]
is_adhesive = [False,True,False,True,False]
arc_approx = 10
```

```python
foldable_robotics.solidworks_support.process(input_filename,output_file_name,prescale,round_digits)
```

    (<foldable_robotics.layer.Layer at 0x1e145acf6d0>,
     <foldable_robotics.layer.Layer at 0x1e145acfc10>,
     [<foldable_robotics.solidworks_support.Component at 0x1e145ac47c0>])

# 1 Layer manufacturing design approach

Generating a perforated hinge for the single layer design:

```python
radius = .01
num_perforations = 5
num_segments = num_perforations*2+1
num_points = num_segments+1
a=numpy.r_[0:1:num_points*1j]
lines = []
for ii in range(int(len(a)/2)-1):
    p1 = sg.Point(a[2*ii+1]+radius,0)
    p2 = sg.Point(a[2*ii+2]-radius,0)
    lines.append(sg.LineString((p1,p2)))
hinge = Layer(*lines)
hinge<<=radius
hinge = Laminate(hinge)

w=hinge_width_calculator(150,1.1)
hinge = hinge.scale(1,w)
hinge.plot()
```

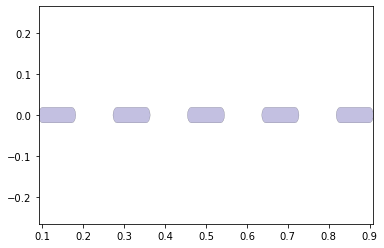
[picture p113: Manufacturing/output_23_0.png]


```python
NUMLAYERS = len(hinge)
NUMLAYERS
```

    1

```python
hinge.plot()
```

png

Creating the main body of the design from the imported DXF. New_output_file_name is the modified design.dxf file.

```python
body = get_bodies(New_output_file_name,'body',NUMLAYERS)
body = foldable_robotics.manufacturing.cleanup(body,.01)
body.plot()
```

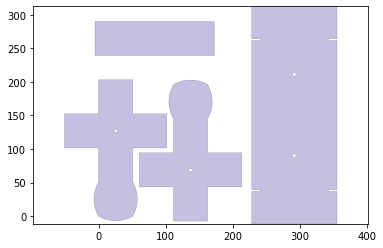
[picture p114: Manufacturing/output_27_0.png]


Plots the perforated hinges at each joint line from the joint layer:

```python
joint_lines= get_hinge_lines(New_output_file_name,'joints')
joints = hinge_lines_to_hinges(joint_lines,hinge)
joints = foldable_robotics.manufacturing.cleanup(joints,.001)
joints.plot()
```

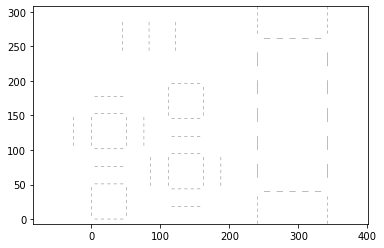
[picture p115: Manufacturing/output_29_0.png]


```python
cuts = get_cuts(New_output_file_name,'cuts',.02,NUMLAYERS)
#cuts.plot()
```

```python
holes = get_holes(output_file_name,'holes',NUMLAYERS)
#holes.plot()
```

Generate holes at vertices to prevent collision:

```python
hole,dummy = foldable_robotics.manufacturing.calc_hole(joint_lines,w)
hole = hole.to_laminate(NUMLAYERS)
hole<<=.2
hole.plot()
```

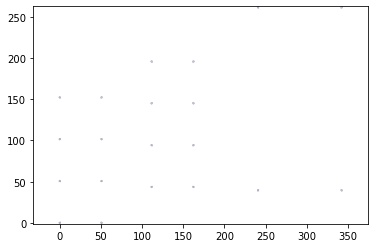
[picture p116: Manufacturing/output_33_0.png]


How the end result will look:

```python
design2 = body- hole - joints - cuts - holes
design2.plot()
```

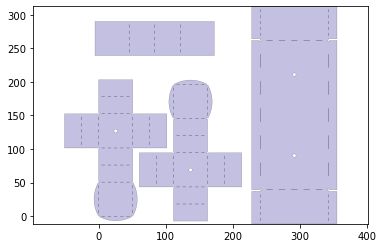
[picture p117: Manufacturing/output_35_0.png]


Generating the keepout. In the single layer case, it is essentially equivalent to design2.

```python
keepout =  foldable_robotics.manufacturing.keepout_laser(design2)
keepout.plot()
```

png

Web and sheet generation:

```python
web,sheet=build_web(design2,keepout,support_width,jig_diameter,jig_hole_spacing,is_adhesive1)
web.plot()
```

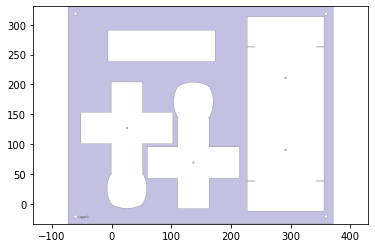
[picture p118: Manufacturing/output_39_0.png]


```python
sheet.plot()
```

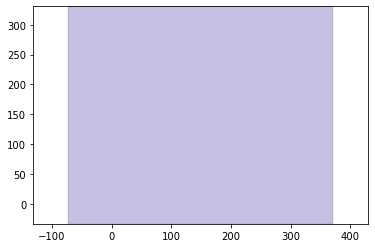
[picture p119: Manufacturing/output_40_0.png]


Since it is one layer, only a first/single pass in needed.

```python
#No cuts at joints, so design2 is the same as the keepout.
first_pass_scrap = sheet - design2
first_pass_scrap = foldable_robotics.manufacturing.cleanup(first_pass_scrap,.00001)
first_pass_scrap.plot()
```

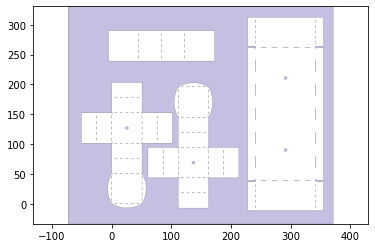
[picture p120: Manufacturing/output_42_0.png]


Generating support:

```python
support = foldable_robotics.manufacturing.support(design2,foldable_robotics.manufacturing.keepout_laser,support_width,support_width/2)
support.plot()
```

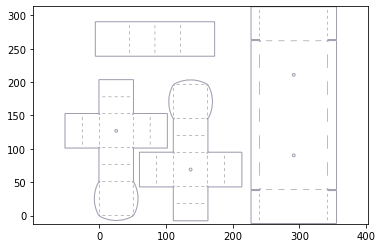
[picture p121: Manufacturing/output_44_0.png]


Merging the web, design2 and support into the supported design:

```python
supported_design = web|design2|support
supported_design.plot()
```

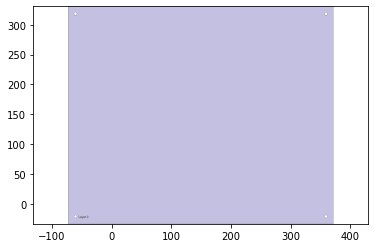
[picture p122: Manufacturing/output_46_0.png]


Plotting the material that will be cut and then the final cut itself:

```python
#cut_line = keepout<<kerf
cut_material = (keepout<<kerf)-keepout
cut_material.plot()
```

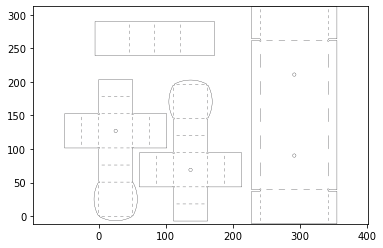
[picture p123: Manufacturing/output_48_0.png]


```python
final_cut = sheet - keepout
final_cut = final_cut[0]
final_cut.plot()
```

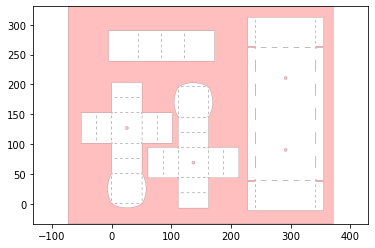
[picture p124: Manufacturing/output_49_0.png]


Plotting the material that will remain after the cut:

```python
remaining_material = supported_design-cut_material
remaining_material.plot()
#make dxf here
```

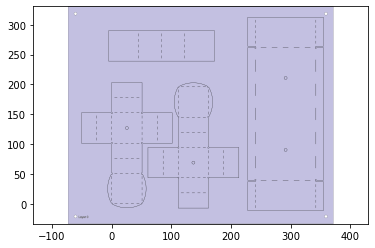
[picture p125: Manufacturing/output_51_0.png]


Plots of each separate piece resulting from the cuts:

```python
remaining_parts = foldable_robotics.manufacturing.find_connected(remaining_material,is_adhesive1)
for item in remaining_parts:
    item.plot(new=True)
```

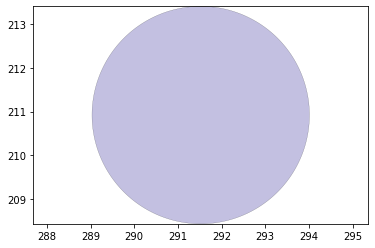
[picture p126: Manufacturing/output_53_0.png]


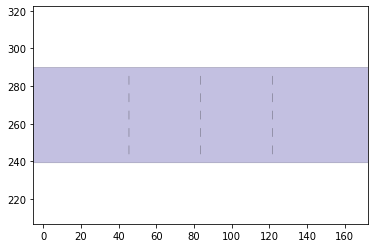
[picture p127: Manufacturing/output_53_1.png]


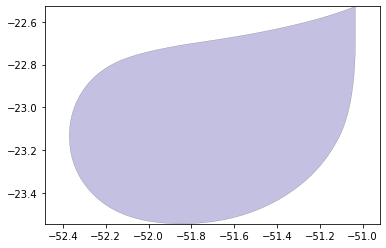
[picture p128: Manufacturing/output_53_2.png]


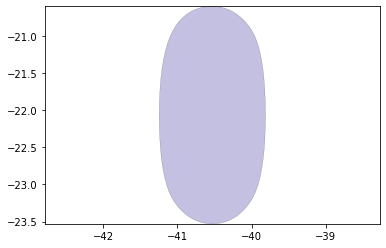
[picture p129: Manufacturing/output_53_3.png]


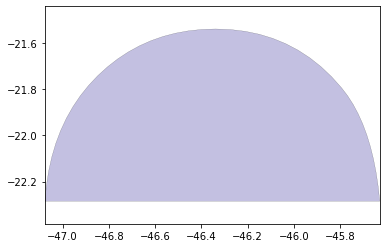
[picture p130: Manufacturing/output_53_4.png]


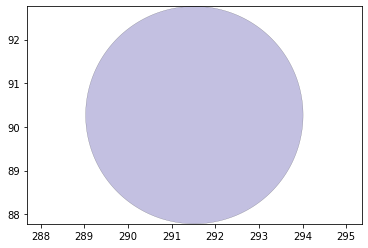
[picture p131: Manufacturing/output_53_5.png]


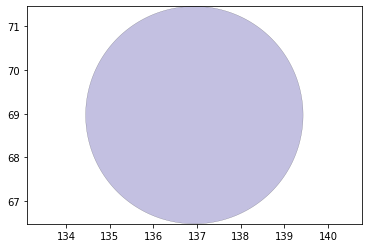
[picture p132: Manufacturing/output_53_6.png]


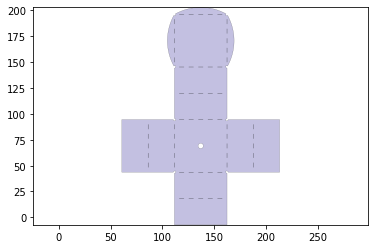
[picture p133: Manufacturing/output_53_7.png]


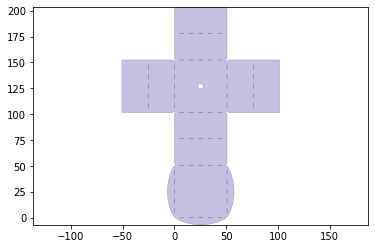
[picture p134: Manufacturing/output_53_8.png]


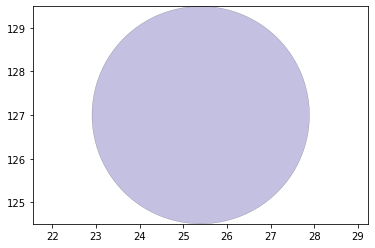
[picture p135: Manufacturing/output_53_9.png]


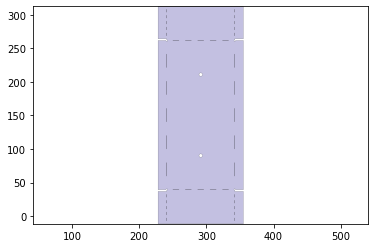
[picture p136: Manufacturing/output_53_10.png]


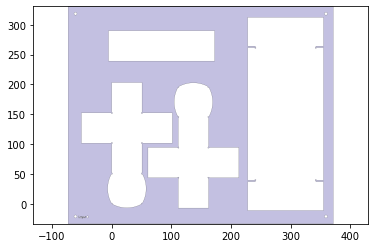
[picture p137: Manufacturing/output_53_11.png]


```python
d3=design2>>1
for item in remaining_parts:
    if not (item&d3).is_null():
        break
check = (item^design2)
print(check.is_null())
```

    False

Exporting 1-layer DXF:

```python
#if check.is_null():
#    supported_design.export_dxf('first_pass')
#    final_cut.export_dxf('second_pass')

#supported_design.export_dxf('first_pass')
final_cut.export_dxf('Single_Layer_Cut')
```

# 5 Layer robot design approach

Generate 5 layer castellated hinge:

```python
hinge = foldable_robotics.parts.castellated_hinge1.generate()
w=hinge_width_calculator(150,1.1)
hinge = hinge.scale(1,w)
hinge.plot()
```

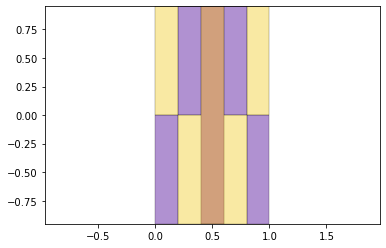
[picture p138: Manufacturing/output_59_0.png]


```python
NUMLAYERS = len(hinge)
NUMLAYERS
```

    5

```python
body = get_bodies(New_output_file_name,'body',NUMLAYERS)
body = foldable_robotics.manufacturing.cleanup(body,.01)
body.plot()
```

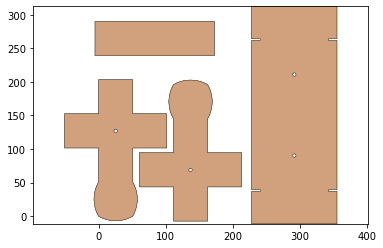
[picture p139: Manufacturing/output_61_0.png]


mapping the hinge design to each joint in your joints layer of the dxf

```python
joint_lines= get_hinge_lines(New_output_file_name,'joints')
joints = hinge_lines_to_hinges(joint_lines,hinge)
joints = foldable_robotics.manufacturing.cleanup(joints,.02)
joints.plot()
```

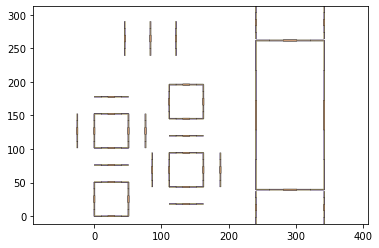
[picture p140: Manufacturing/output_63_0.png]


```python
cuts = get_cuts(New_output_file_name,'cuts',.02,NUMLAYERS)
#cuts.plot()
```

```python
holes = get_holes(output_file_name,'holes',NUMLAYERS)
#holes.plot()
```

holes computed for any vertices

```python
hole,dummy = foldable_robotics.manufacturing.calc_hole(joint_lines,w)
hole = hole.to_laminate(NUMLAYERS)
hole<<=.2
hole.plot()
```

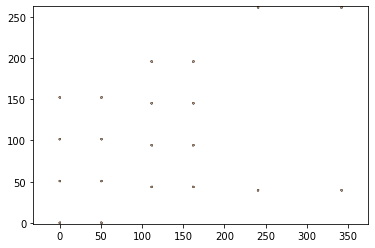
[picture p141: Manufacturing/output_67_0.png]


# 5 Layer manufacturing design approach

Subtracting hole, cut, and joint geometries from the body, resulting in the intended design:

```python
design2 = body- hole - joints - cuts - holes
design2.plot()
```

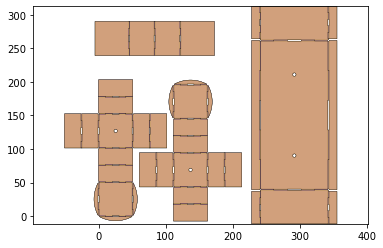
[picture p142: Manufacturing/output_70_0.png]


```python
keepout =  foldable_robotics.manufacturing.keepout_laser(design2)
keepout.plot()
```

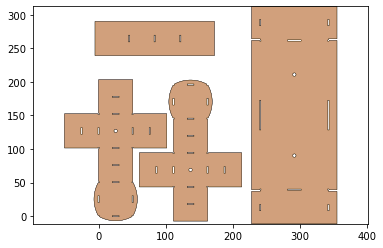
[picture p143: Manufacturing/output_71_0.png]


Web design

```python
web,sheet=build_web(design2,keepout,support_width,jig_diameter,jig_hole_spacing,is_adhesive)
web.plot()
```

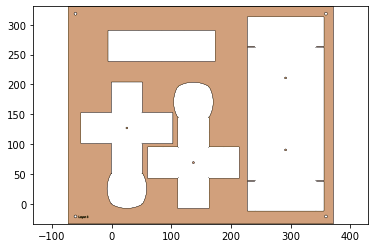
[picture p144: Manufacturing/output_73_0.png]


```python
sheet.plot()
```

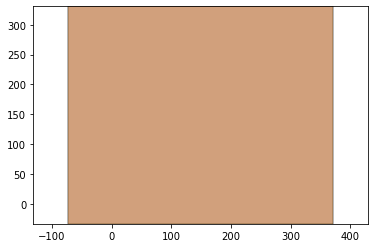
[picture p145: Manufacturing/output_74_0.png]


```python
second_pass_scrap = sheet-keepout
first_pass_scrap = sheet - design2-second_pass_scrap
first_pass_scrap = foldable_robotics.manufacturing.cleanup(first_pass_scrap,.00001)
first_pass_scrap.plot()
```

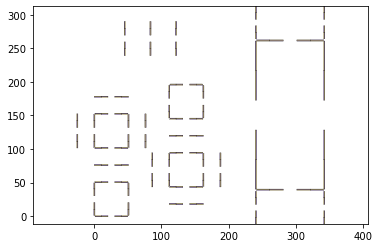
[picture p146: Manufacturing/output_75_0.png]


Support design

```python
support = foldable_robotics.manufacturing.support(design2,foldable_robotics.manufacturing.keepout_laser,support_width,support_width/2)
support.plot()
```

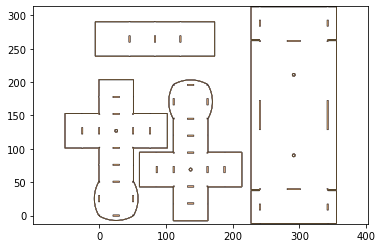
[picture p147: Manufacturing/output_77_0.png]


```python
#Calculate the web by using only the material which can be cut, minus a gap determined by the support width.  Is that the only material you can use?
supported_design = web|design2|support
supported_design.plot()
```

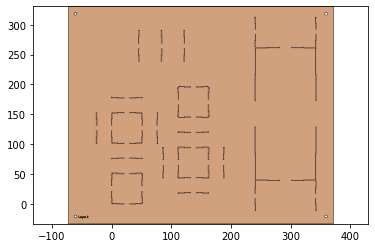
[picture p148: Manufacturing/output_78_0.png]


```python
#cut_line = keepout<<kerf
cut_material = (keepout<<kerf)-keepout
cut_material.plot()
```

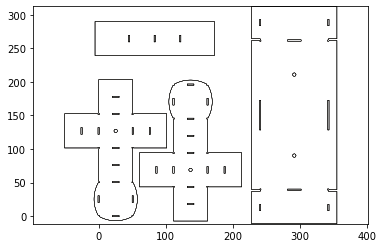
[picture p149: Manufacturing/output_79_0.png]


```python
final_cut = sheet - keepout
final_cut = final_cut[0]
final_cut.plot()
```

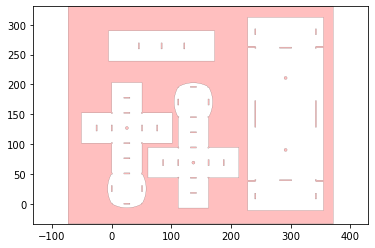
[picture p150: Manufacturing/output_80_0.png]


Full cutsheet

```python
remaining_material = supported_design-cut_material
remaining_material.plot()
#make dxf here
```

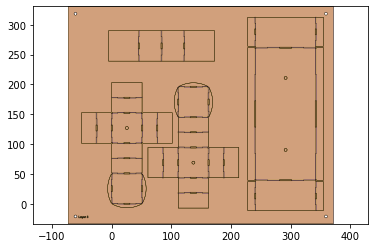
[picture p151: Manufacturing/output_82_0.png]


Connection check

```python
remaining_parts = foldable_robotics.manufacturing.find_connected(remaining_material,is_adhesive)
for item in remaining_parts:
    item.plot(new=True)
```

    C:\Users\ansah\anaconda3\lib\site-packages\foldable_robotics\laminate.py:91: RuntimeWarning: More than 20 figures have been opened. Figures created through the pyplot interface (`matplotlib.pyplot.figure`) are retained until explicitly closed and may consume too much memory. (To control this warning, see the rcParam `figure.max_open_warning`).
      plt.figure()

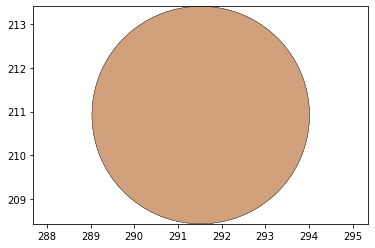
[picture p152: Manufacturing/output_84_1.png]


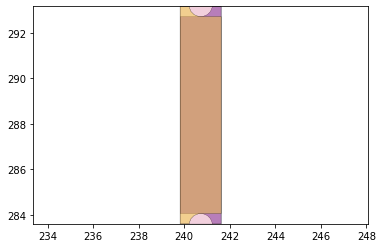
[picture p153: Manufacturing/output_84_2.png]


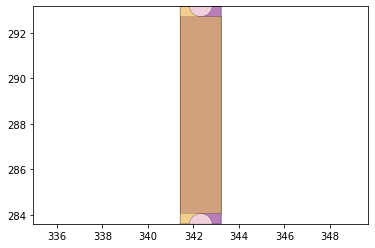
[picture p154: Manufacturing/output_84_3.png]


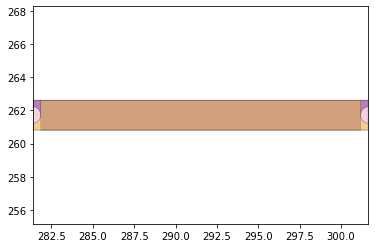
[picture p155: Manufacturing/output_84_4.png]


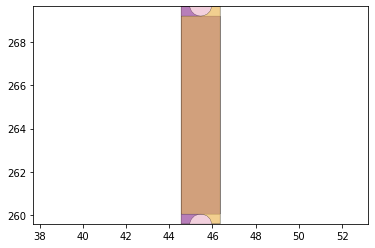
[picture p156: Manufacturing/output_84_5.png]


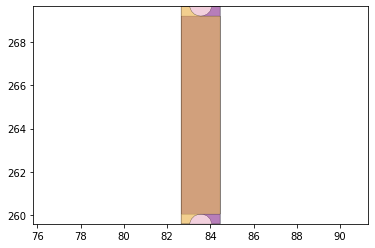
[picture p157: Manufacturing/output_84_6.png]


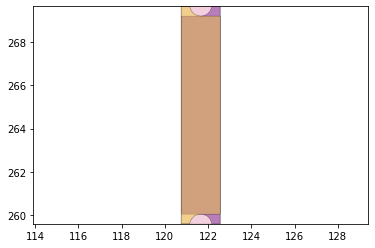
[picture p158: Manufacturing/output_84_7.png]


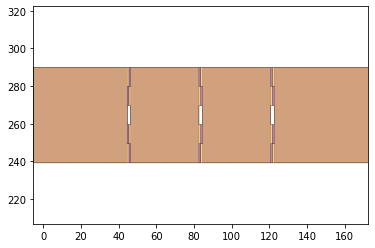
[picture p159: Manufacturing/output_84_8.png]


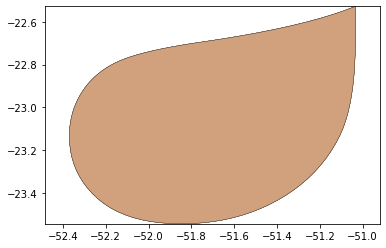
[picture p160: Manufacturing/output_84_9.png]


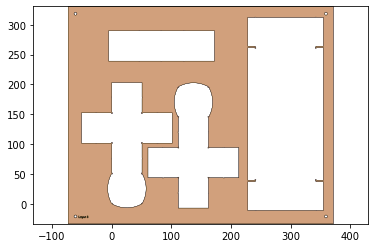
[picture p161: Manufacturing/output_84_10.png]


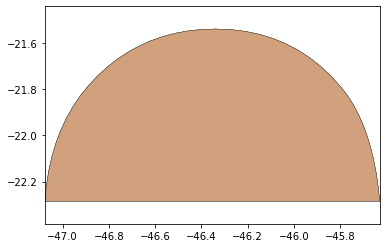
[picture p162: Manufacturing/output_84_11.png]


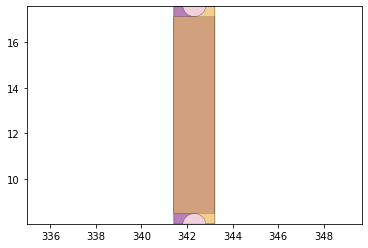
[picture p163: Manufacturing/output_84_12.png]


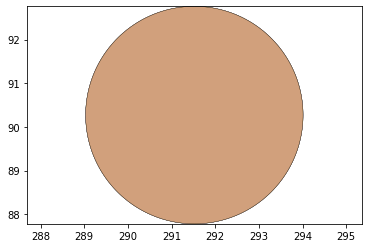
[picture p164: Manufacturing/output_84_13.png]


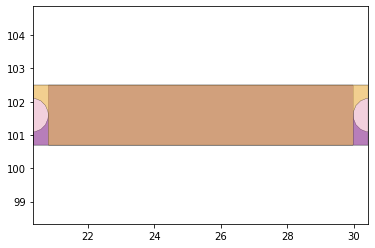
[picture p165: Manufacturing/output_84_14.png]


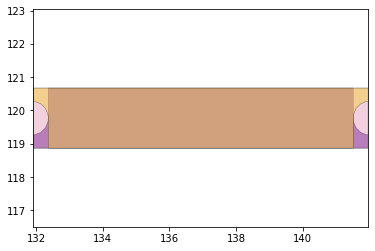
[picture p166: Manufacturing/output_84_15.png]


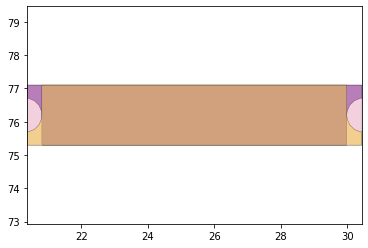
[picture p167: Manufacturing/output_84_16.png]


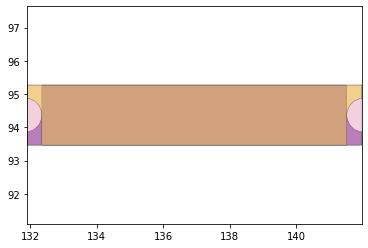
[picture p168: Manufacturing/output_84_17.png]


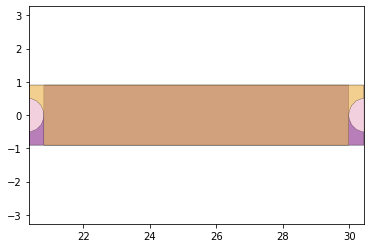
[picture p169: Manufacturing/output_84_18.png]


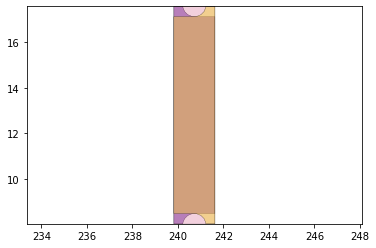
[picture p170: Manufacturing/output_84_19.png]


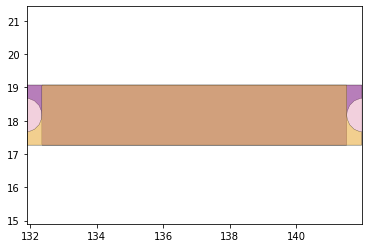
[picture p171: Manufacturing/output_84_20.png]


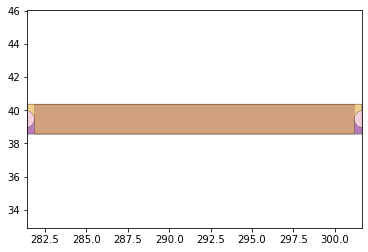
[picture p172: Manufacturing/output_84_21.png]


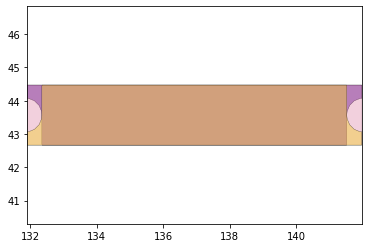
[picture p173: Manufacturing/output_84_22.png]


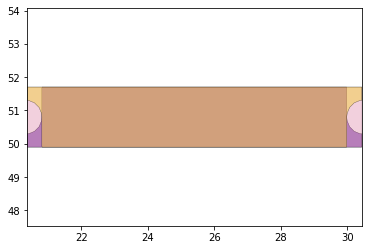
[picture p174: Manufacturing/output_84_23.png]


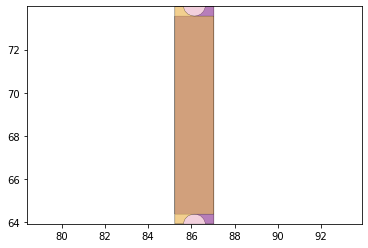
[picture p175: Manufacturing/output_84_24.png]


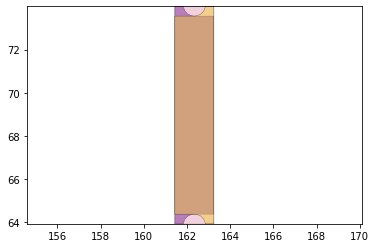
[picture p176: Manufacturing/output_84_25.png]


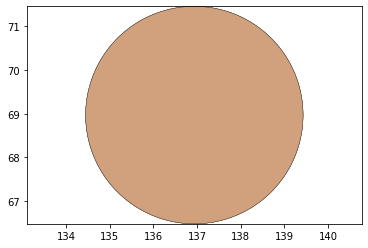
[picture p177: Manufacturing/output_84_26.png]


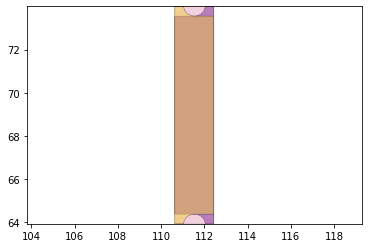
[picture p178: Manufacturing/output_84_27.png]


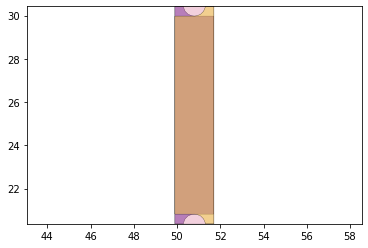
[picture p179: Manufacturing/output_84_28.png]


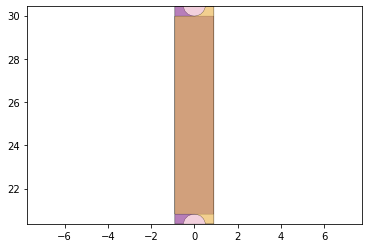
[picture p180: Manufacturing/output_84_29.png]


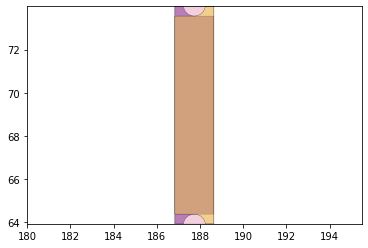
[picture p181: Manufacturing/output_84_30.png]


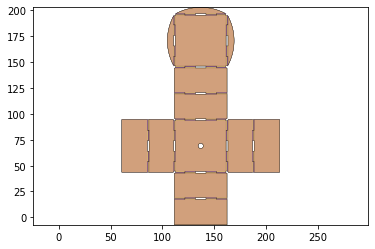
[picture p182: Manufacturing/output_84_31.png]


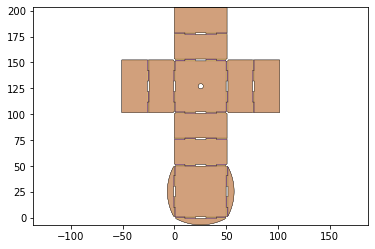
[picture p183: Manufacturing/output_84_32.png]


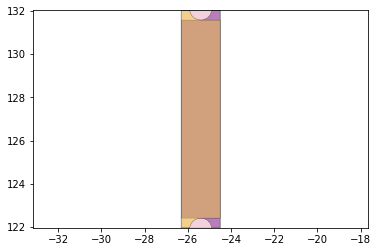
[picture p184: Manufacturing/output_84_33.png]


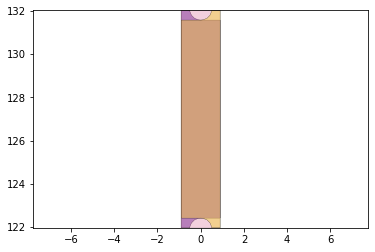
[picture p185: Manufacturing/output_84_34.png]


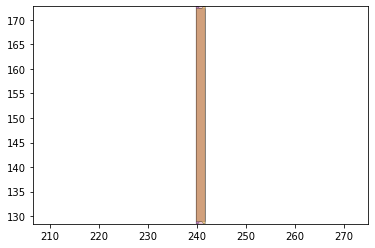
[picture p186: Manufacturing/output_84_35.png]


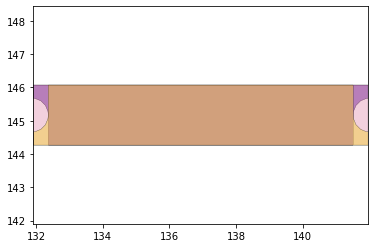
[picture p187: Manufacturing/output_84_36.png]


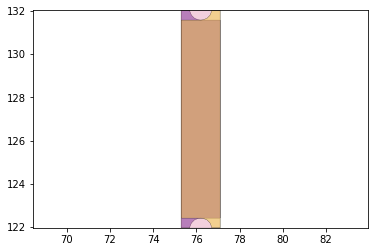
[picture p188: Manufacturing/output_84_37.png]


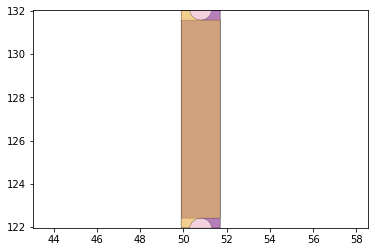
[picture p189: Manufacturing/output_84_38.png]


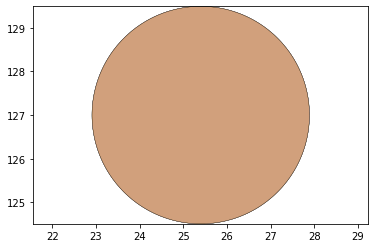
[picture p190: Manufacturing/output_84_39.png]


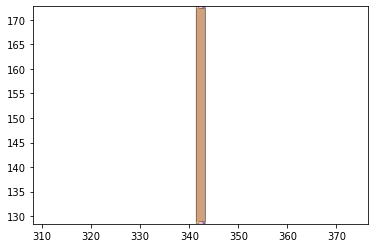
[picture p191: Manufacturing/output_84_40.png]


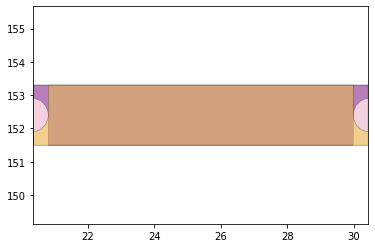
[picture p192: Manufacturing/output_84_41.png]


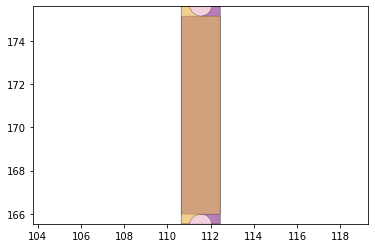
[picture p193: Manufacturing/output_84_42.png]


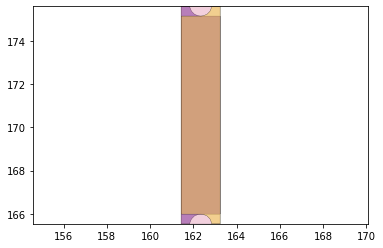
[picture p194: Manufacturing/output_84_43.png]


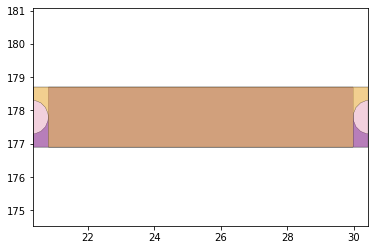
[picture p195: Manufacturing/output_84_44.png]


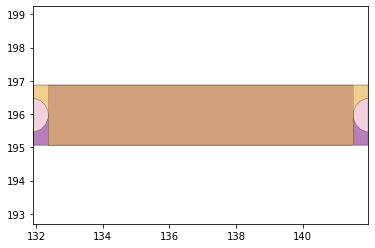
[picture p196: Manufacturing/output_84_45.png]


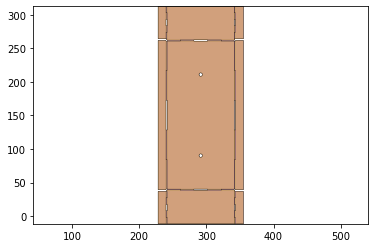
[picture p197: Manufacturing/output_84_46.png]


```python
d3=design2>>1
for item in remaining_parts:
    if not (item&d3).is_null():
        break
check = (item^design2)
print(check.is_null())
```

    False

```python
if check.is_null():
    supported_design.export_dxf('first_pass')
    final_cut.export_dxf('second_pass')

```

```python
w,h = supported_design.get_dimensions()
p0,p1 = supported_design.bounding_box_coords()

rigid_layer = supported_design[0] | (supported_design[-1].translate(w+10,0))
rigid_layer.plot()
```

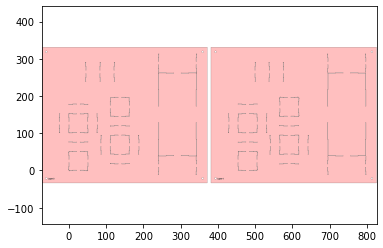
[picture p198: Manufacturing/output_87_0.png]


```python
l4 = supported_design[3].scale(-1,1)
p2,p3 = l4.bounding_box_coords()
l4 = l4.translate(p0[0]-p2[0]+10+w,p0[1]-p2[1])

adhesive_layer = supported_design[1] | l4
adhesive_layer.plot()
```

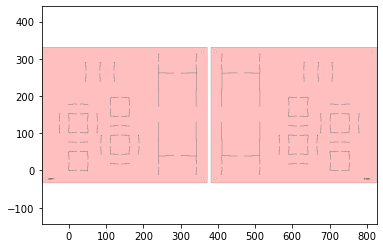
[picture p199: Manufacturing/output_88_0.png]


```python
first_pass = Laminate(rigid_layer,adhesive_layer,supported_design[2])
if check.is_null():
    first_pass.export_dxf('first_pass')
    final_cut.export_dxf('final_cut')
```

```python
check.is_null()
```

    False

Exporting 5-layer DXFs:

```python
rigid_layer.export_dxf('rigid_layer')
adhesive_layer.export_dxf('adhesive_layer')
final_cut.export_dxf('final_cut')
```

# 5 Final DXF files

Single layer DXF:

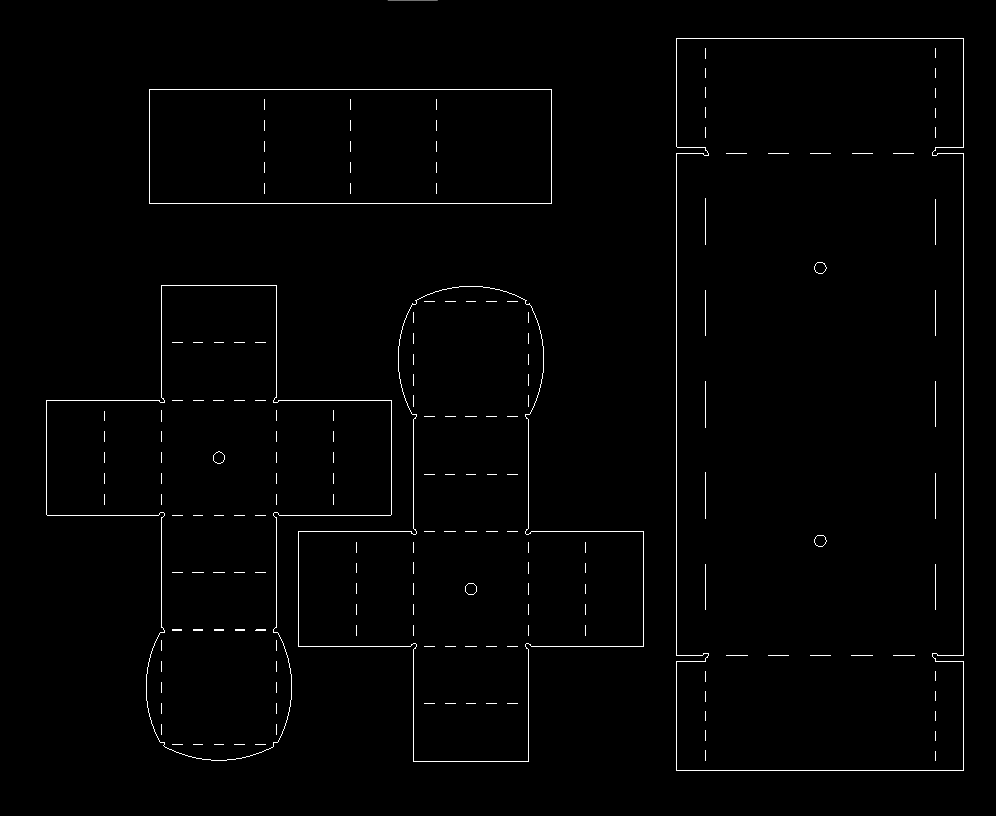
[picture p200: Manufacturing/SingleLayer.PNG]


5-layer adhesive DXF:

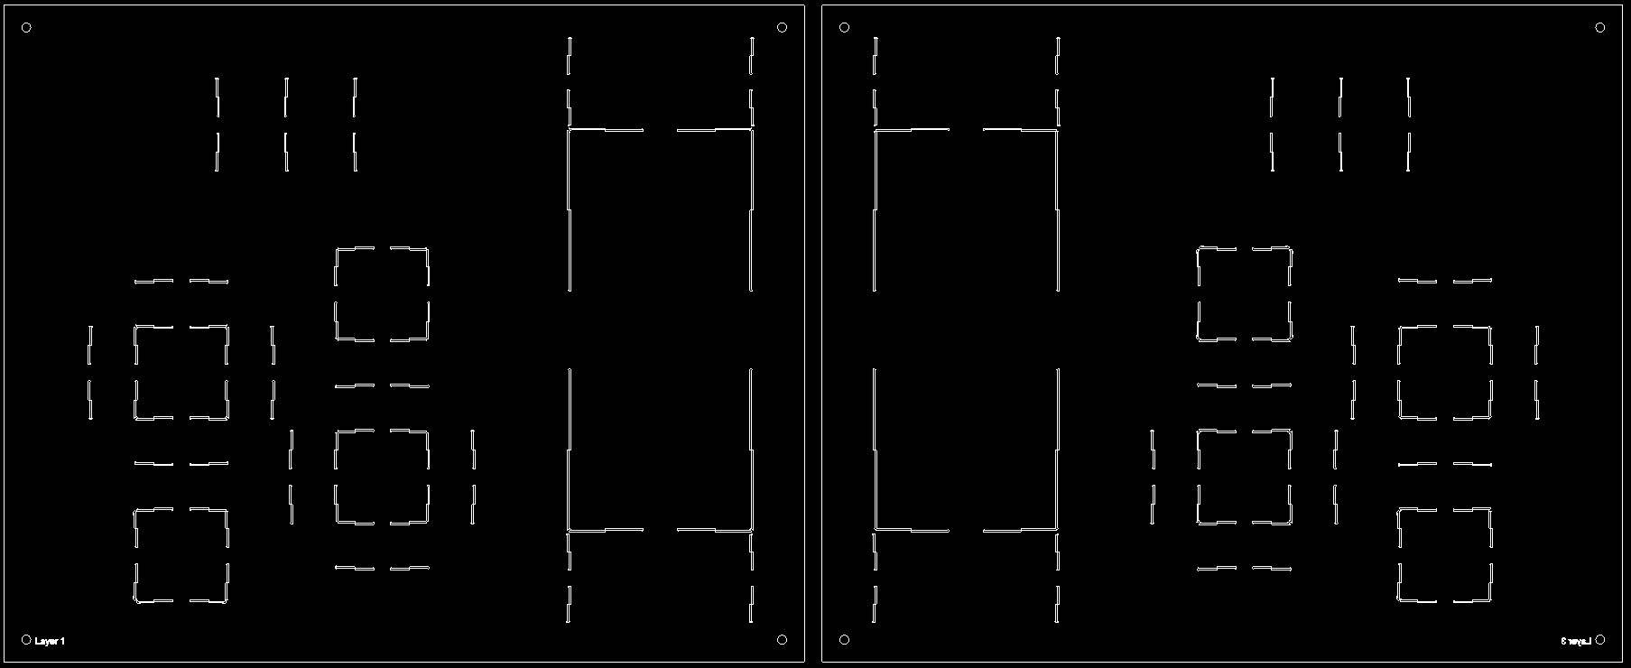
[picture p201: Manufacturing/AdhesiveLayer.PNG]


5-layer rigid DXF:

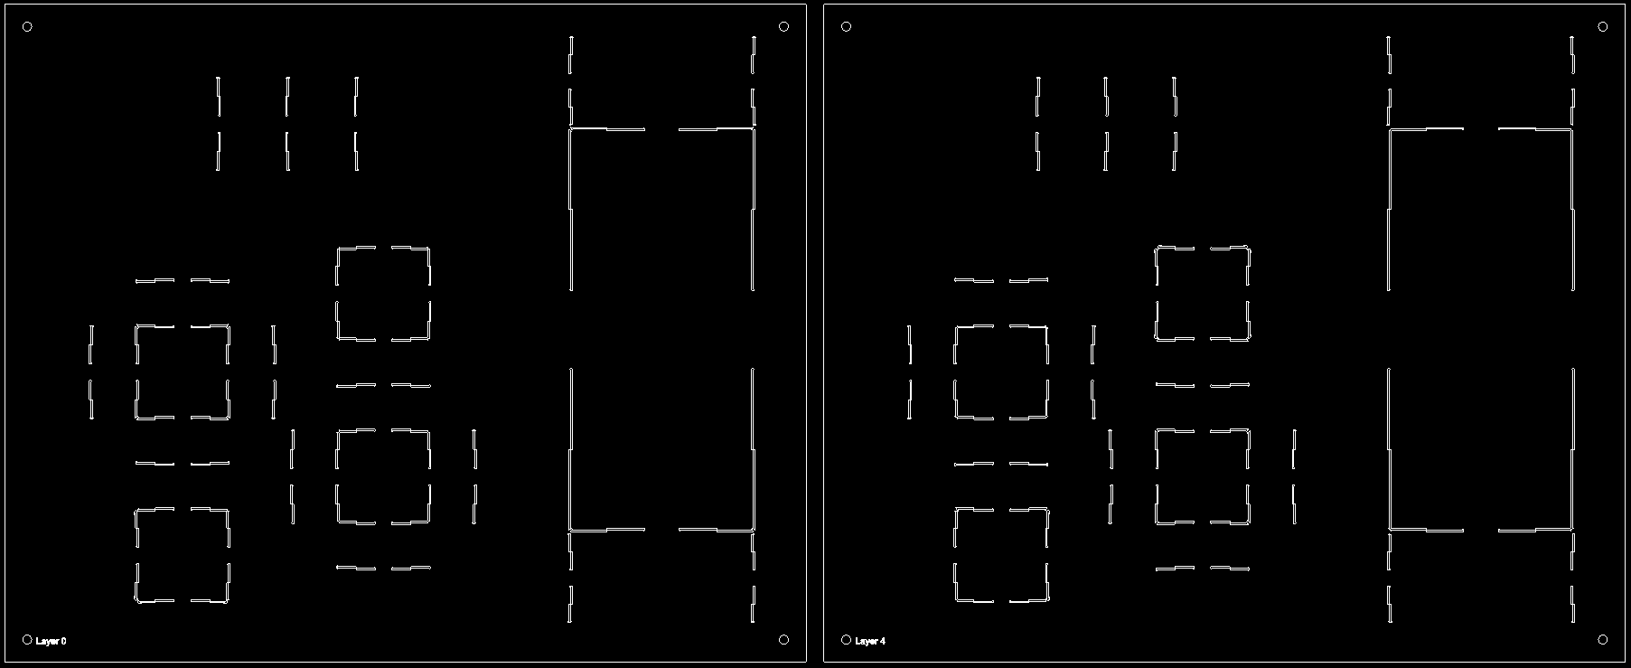
[picture p202: Manufacturing/RigidLayer.PNG]


5-layer final cut DXF:

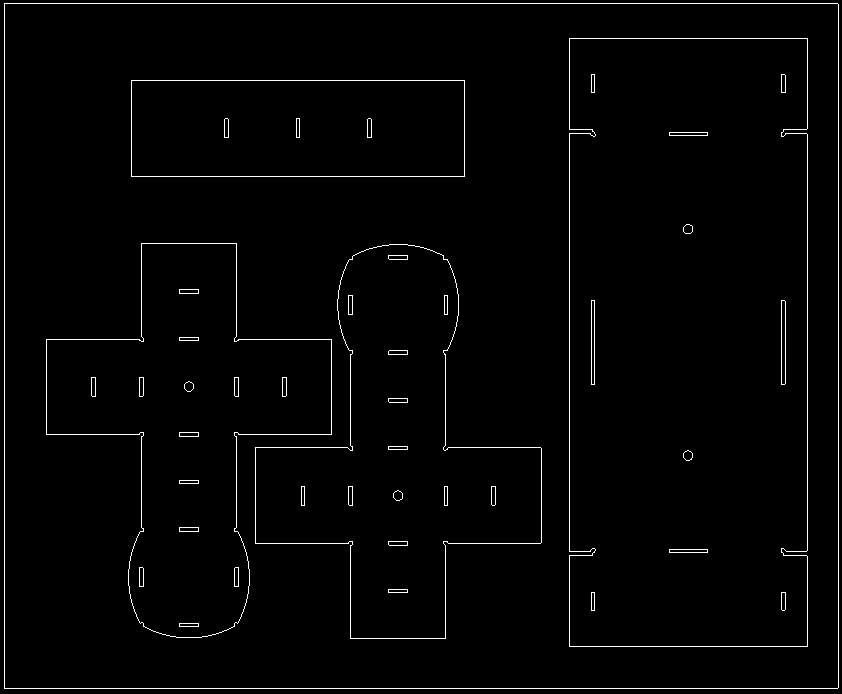
[picture p203: Manufacturing/FinalCut.PNG]
