L-terrestris/L-terrestris.github.io/Validation/fig4.png

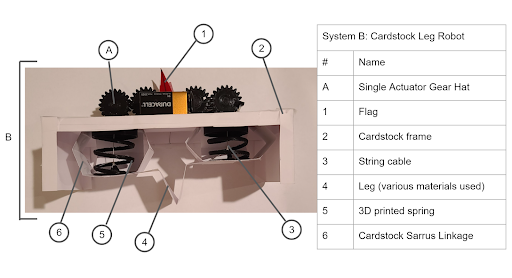
Validation/fig4.png
