L-terrestris/L-terrestris.github.io/(commit log)

2021-02-28 Update and rename Kinematics.md to Kinematics/Kinematics.md
2021-03-28 Update and rename Team5_SystemKinematics.md to KinematicsNew.md
